intechstudio/grid-hardware/Electrical/Design/PCBA-ZONA-TOUCH/PCBA-ZONA-TOUCH.kicad_pcb

## KiCad design Electrical/Design/PCBA-ZONA-TOUCH/PCBA-ZONA-TOUCH.kicad_pcb (2026-10-08)

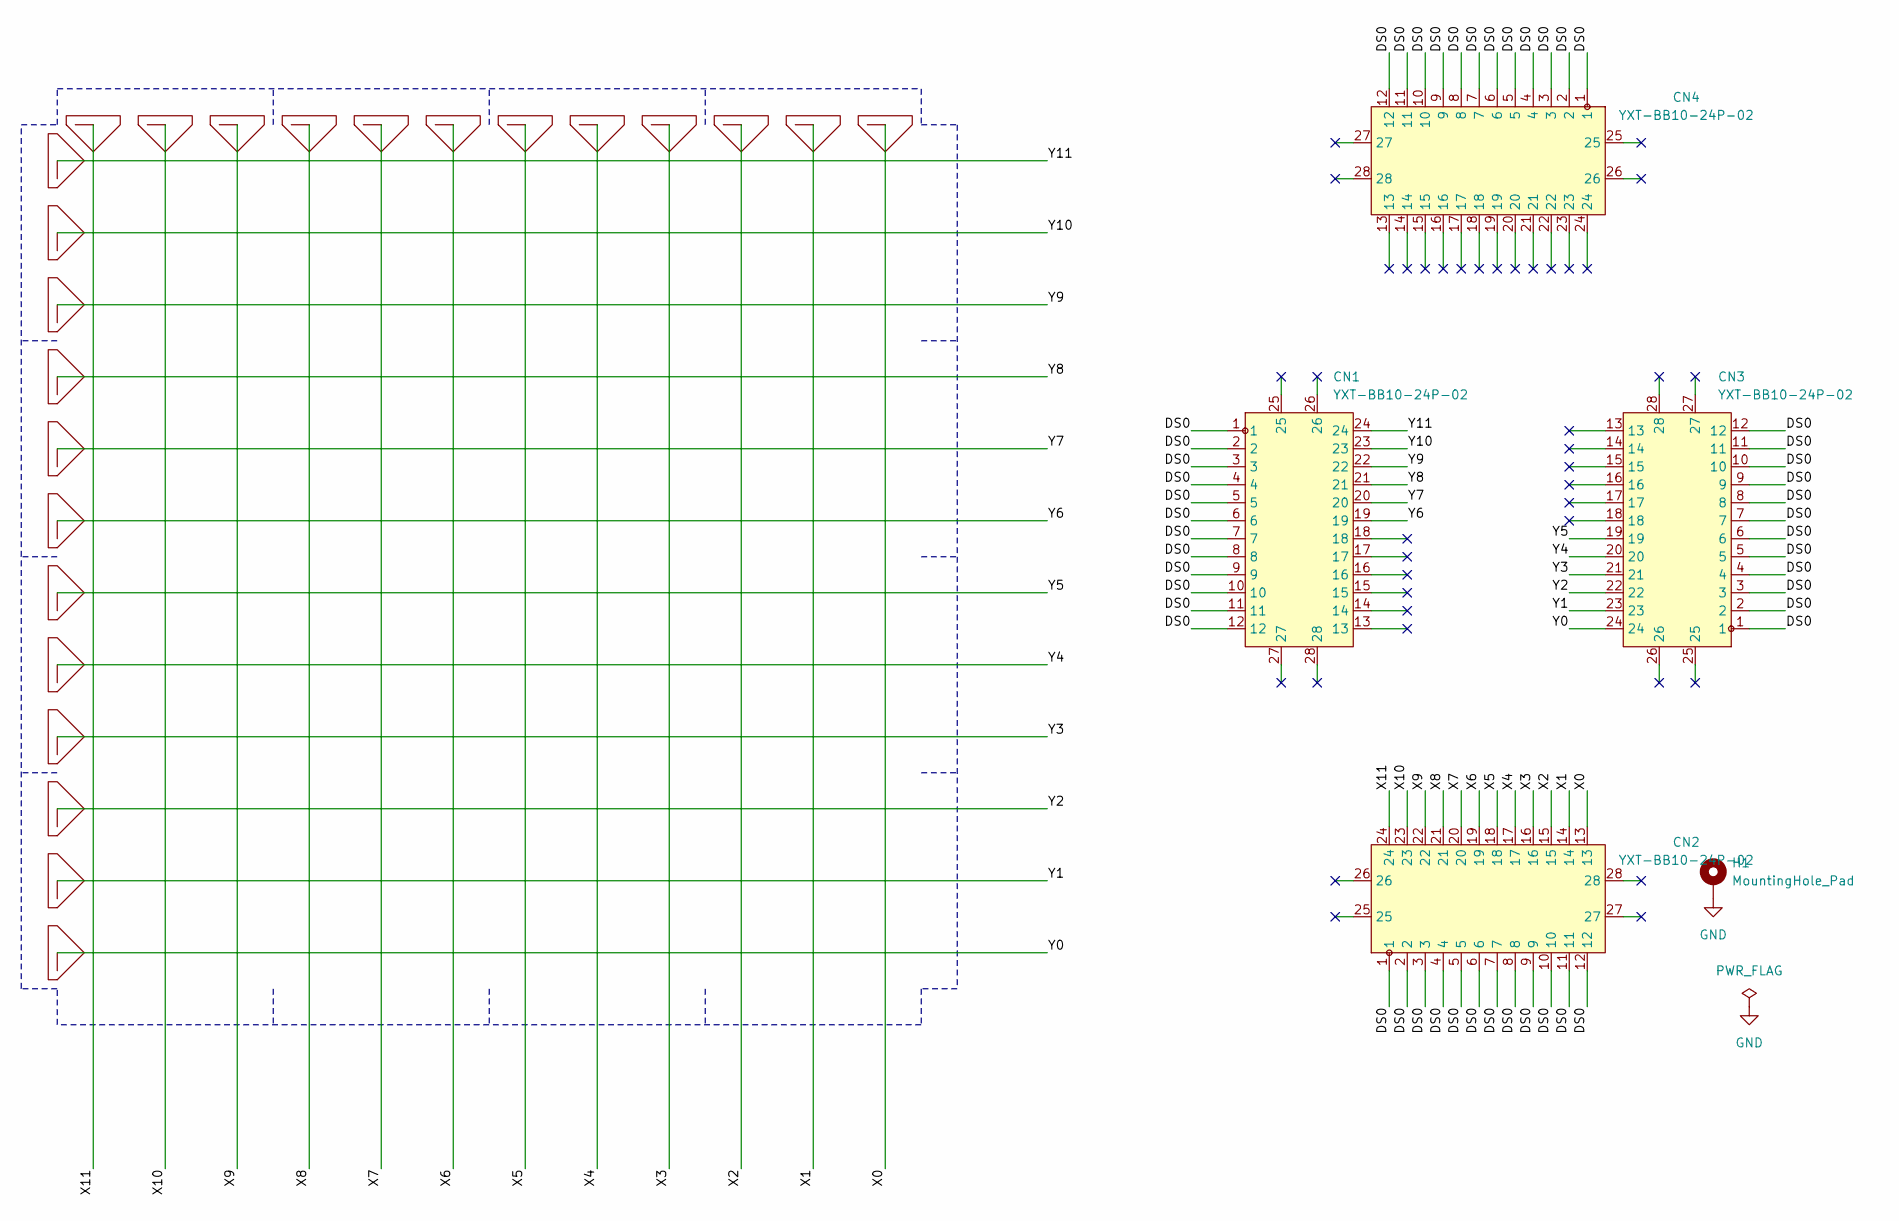
[picture p1: schematic PCBA-ZONA-TOUCH.kicad_sch]

Parts:
CN1, CN2, CN3, CN4: YXT-BB10-24P-02; CONN-SMD_24P-P0.4-YXT-BB10-24P-02; MPN YXT-BB10-24P-02; LCSC Part C2763973
CS1, CS2, CS3, CS4, CS5, CS6, CS7, CS8, CS9, CS10, CS11, CS12, CS13, CS38, CS63, CS88, CS113, CS138, CS163, CS188, CS213, CS238, CS263, CS288: capsense_diamond_edge; capsense_column
H1: MountingHole_Pad; zona-edgeplate-via

Connections:
/DS0: CN1.1, CN1.2, CN1.3, CN1.4, CN1.5, CN1.6, CN1.7, CN1.8, CN1.9, CN1.10, CN1.11, CN1.12, CN2.1, CN2.2, CN2.3, CN2.4, CN2.5, CN2.6, CN2.7, CN2.8, CN2.9, CN2.10, CN2.11, CN2.12, CN3.1, CN3.2, CN3.3, CN3.4, CN3.5, CN3.6, CN3.7, CN3.8, CN3.9, CN3.10, CN3.11, CN3.12, CN4.1, CN4.2, CN4.3, CN4.4, CN4.5, CN4.6, CN4.7, CN4.8, CN4.9, CN4.10, CN4.11, CN4.12
/X0: CN2.13, CS288.1 (1_1)
/X1: CN2.14, CS263.1 (1_1)
/X2: CN2.15, CS238.1 (1_1)
/X3: CN2.16, CS213.1 (1_1)
/X4: CN2.17, CS188.1 (1_1)
/X5: CN2.18, CS163.1 (1_1)
/X6: CN2.19, CS138.1 (1_1)
/X7: CN2.20, CS113.1 (1_1)
/X8: CN2.21, CS88.1 (1_1)
/X9: CN2.22, CS63.1 (1_1)
/X10: CN2.23, CS38.1 (1_1)
/X11: CN2.24, CS13.1 (1_1)
/Y0: CN3.24, CS12.1 (1_1)
/Y1: CN3.23, CS11.1 (1_1)
/Y2: CN3.22, CS10.1 (1_1)
/Y3: CN3.21, CS9.1 (1_1)
/Y4: CN3.20, CS8.1 (1_1)
/Y5: CN3.19, CS7.1 (1_1)
/Y6: CN1.19, CS6.1 (1_1)
/Y7: CN1.20, CS5.1 (1_1)
/Y8: CN1.21, CS4.1 (1_1)
/Y9: CN1.22, CS3.1 (1_1)
/Y10: CN1.23, CS2.1 (1_1)
/Y11: CN1.24, CS1.1 (1_1)
GND: H1.1 (1_1)

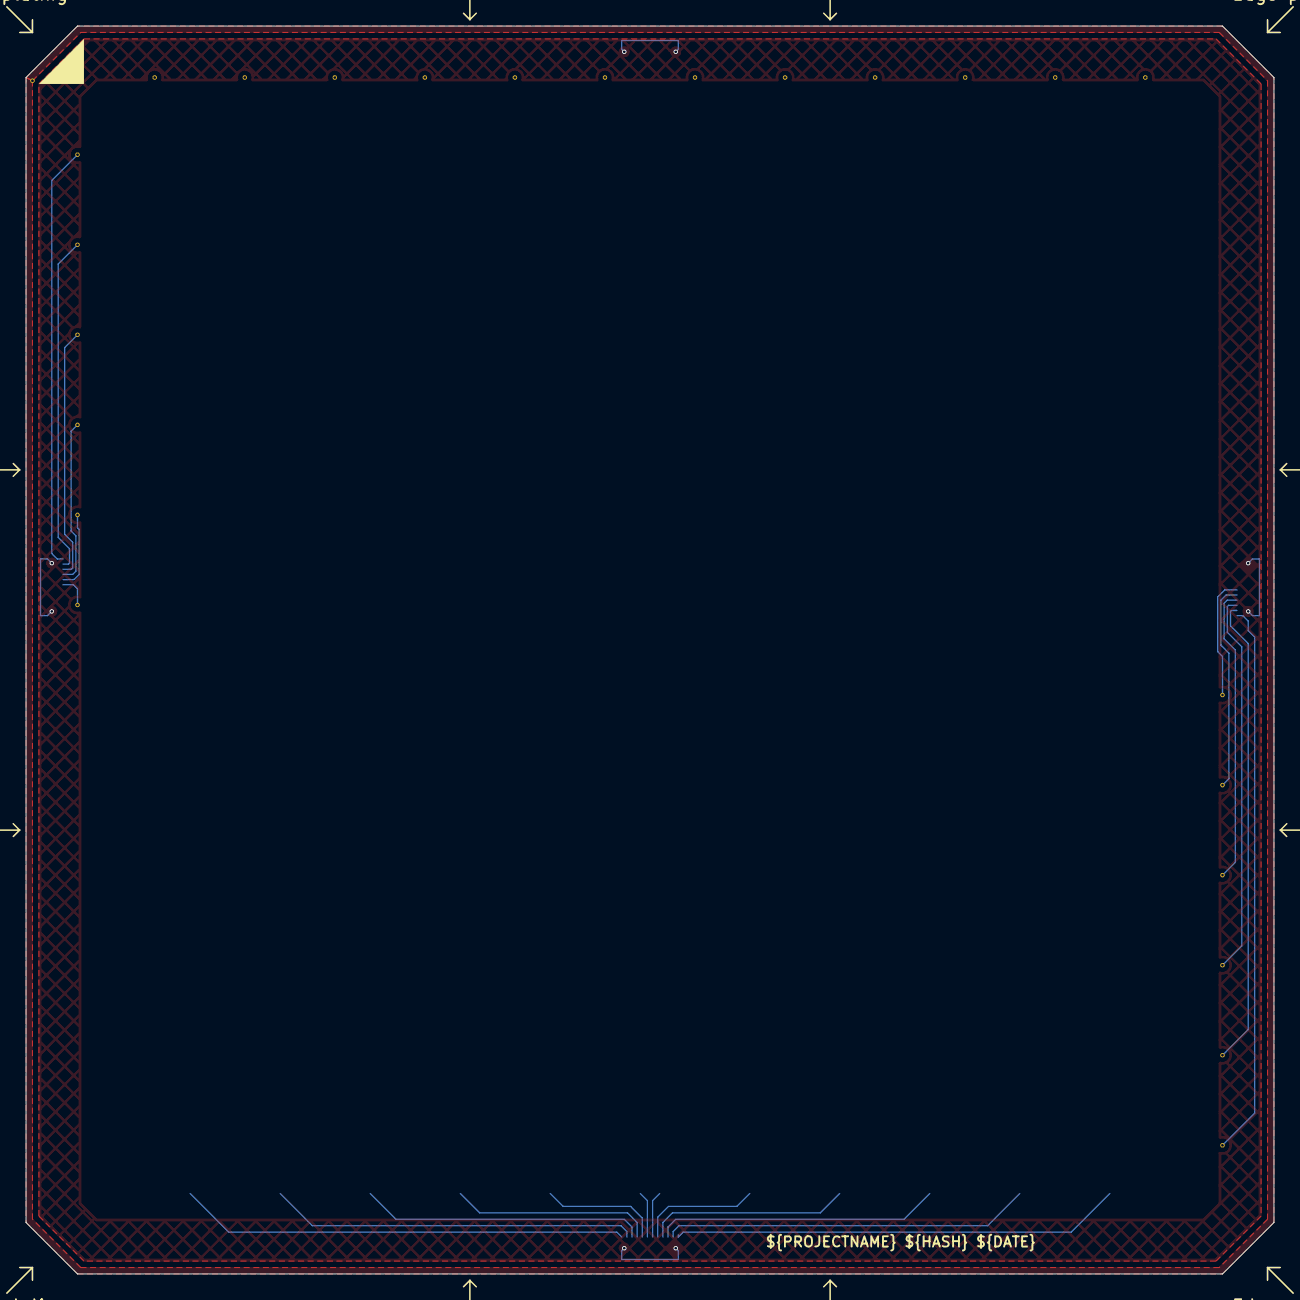
[picture p2: board PCBA-ZONA-TOUCH.kicad_pcb from above]

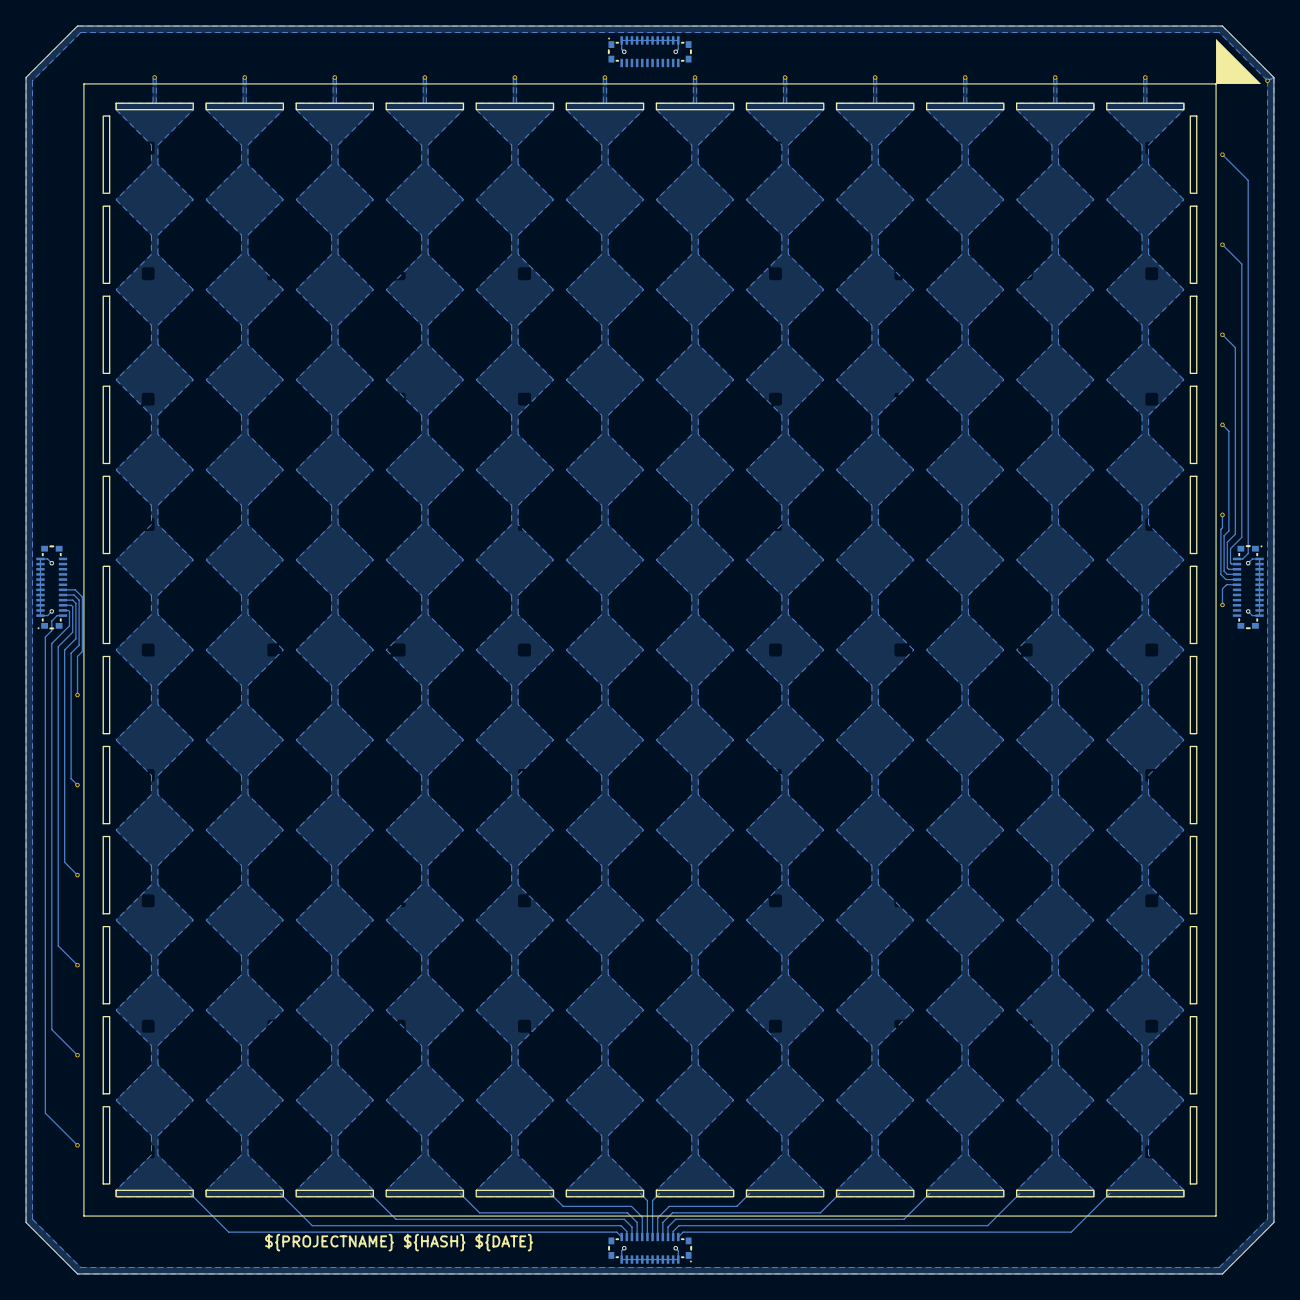
[picture p3: board PCBA-ZONA-TOUCH.kicad_pcb from below]

Board: 4 copper layers, 97.0 x 97.0 mm, 29 parts (4 on the bottom side), 25 nets.
