intechstudio/grid-hardware/Electrical/Design/PCBA-PO16/PCBA-PO16.kicad_pcb

## KiCad design Electrical/Design/PCBA-PO16/PCBA-PO16.kicad_pcb (2026-09-08)

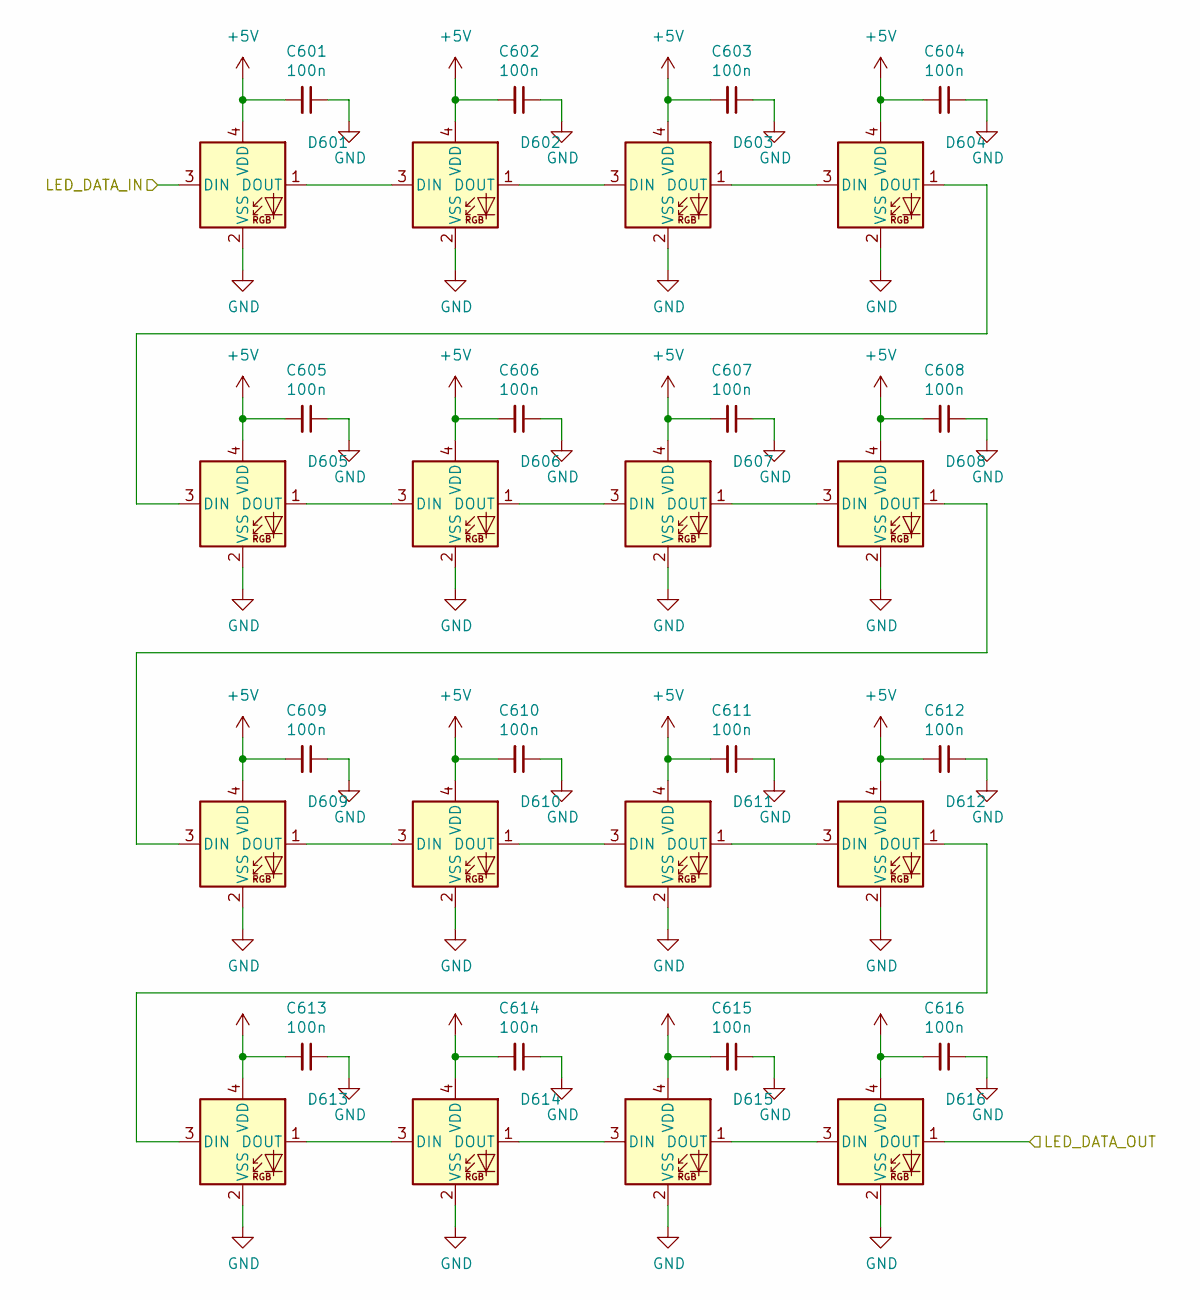
[picture p9: schematic UI_LED.kicad_sch]

Parts:
C601, C602, C603, C604, C605, C606, C607, C608, C609, C610, C611, C612, C613, C614, C615, C616: 100n; CAP_0402
D601, D602, D603, D604, D605, D606, D607, D608, D609, D610, D611, D612, D613, D614, D615, D616: XL-0807RGBC-2812B-S; UI_XL-0807RGBC-2812B-S

Connections:
+5V: C601.2, C602.2, C603.2, C604.2, C605.2, C606.2, C607.2, C608.2, C609.2, C610.2, C611.2, C612.2, C613.2, C614.2, C615.2, C616.2, D601.4 (VDD), D602.4 (VDD), D603.4 (VDD), D604.4 (VDD), D605.4 (VDD), D606.4 (VDD), D607.4 (VDD), D608.4 (VDD), D609.4 (VDD), D610.4 (VDD), D611.4 (VDD), D612.4 (VDD), D613.4 (VDD), D614.4 (VDD), D615.4 (VDD), D616.4 (VDD); also elsewhere on the board
/MCU/LED_DATA_OUT: D601.3 (DIN); also elsewhere on the board
/UI_LED/LED_DATA_OUT: D616.1 (DOUT)
GND: C601.1, C602.1, C603.1, C604.1, C605.1, C606.1, C607.1, C608.1, C609.1, C610.1, C611.1, C612.1, C613.1, C614.1, C615.1, C616.1, D601.2 (VSS), D602.2 (VSS), D603.2 (VSS), D604.2 (VSS), D605.2 (VSS), D606.2 (VSS), D607.2 (VSS), D608.2 (VSS), D609.2 (VSS), D610.2 (VSS), D611.2 (VSS), D612.2 (VSS), D613.2 (VSS), D614.2 (VSS), D615.2 (VSS), D616.2 (VSS); also elsewhere on the board
unnamed: D601.1 (DOUT), D602.3 (DIN)
unnamed: D602.1 (DOUT), D603.3 (DIN)
unnamed: D603.1 (DOUT), D604.3 (DIN)
unnamed: D604.1 (DOUT), D605.3 (DIN)
unnamed: D605.1 (DOUT), D606.3 (DIN)
unnamed: D606.1 (DOUT), D607.3 (DIN)
unnamed: D607.1 (DOUT), D608.3 (DIN)
unnamed: D608.1 (DOUT), D609.3 (DIN)
unnamed: D609.1 (DOUT), D610.3 (DIN)
unnamed: D610.1 (DOUT), D611.3 (DIN)
unnamed: D611.1 (DOUT), D612.3 (DIN)
unnamed: D612.1 (DOUT), D613.3 (DIN)
unnamed: D613.1 (DOUT), D614.3 (DIN)
unnamed: D614.1 (DOUT), D615.3 (DIN)
unnamed: D615.1 (DOUT), D616.3 (DIN)

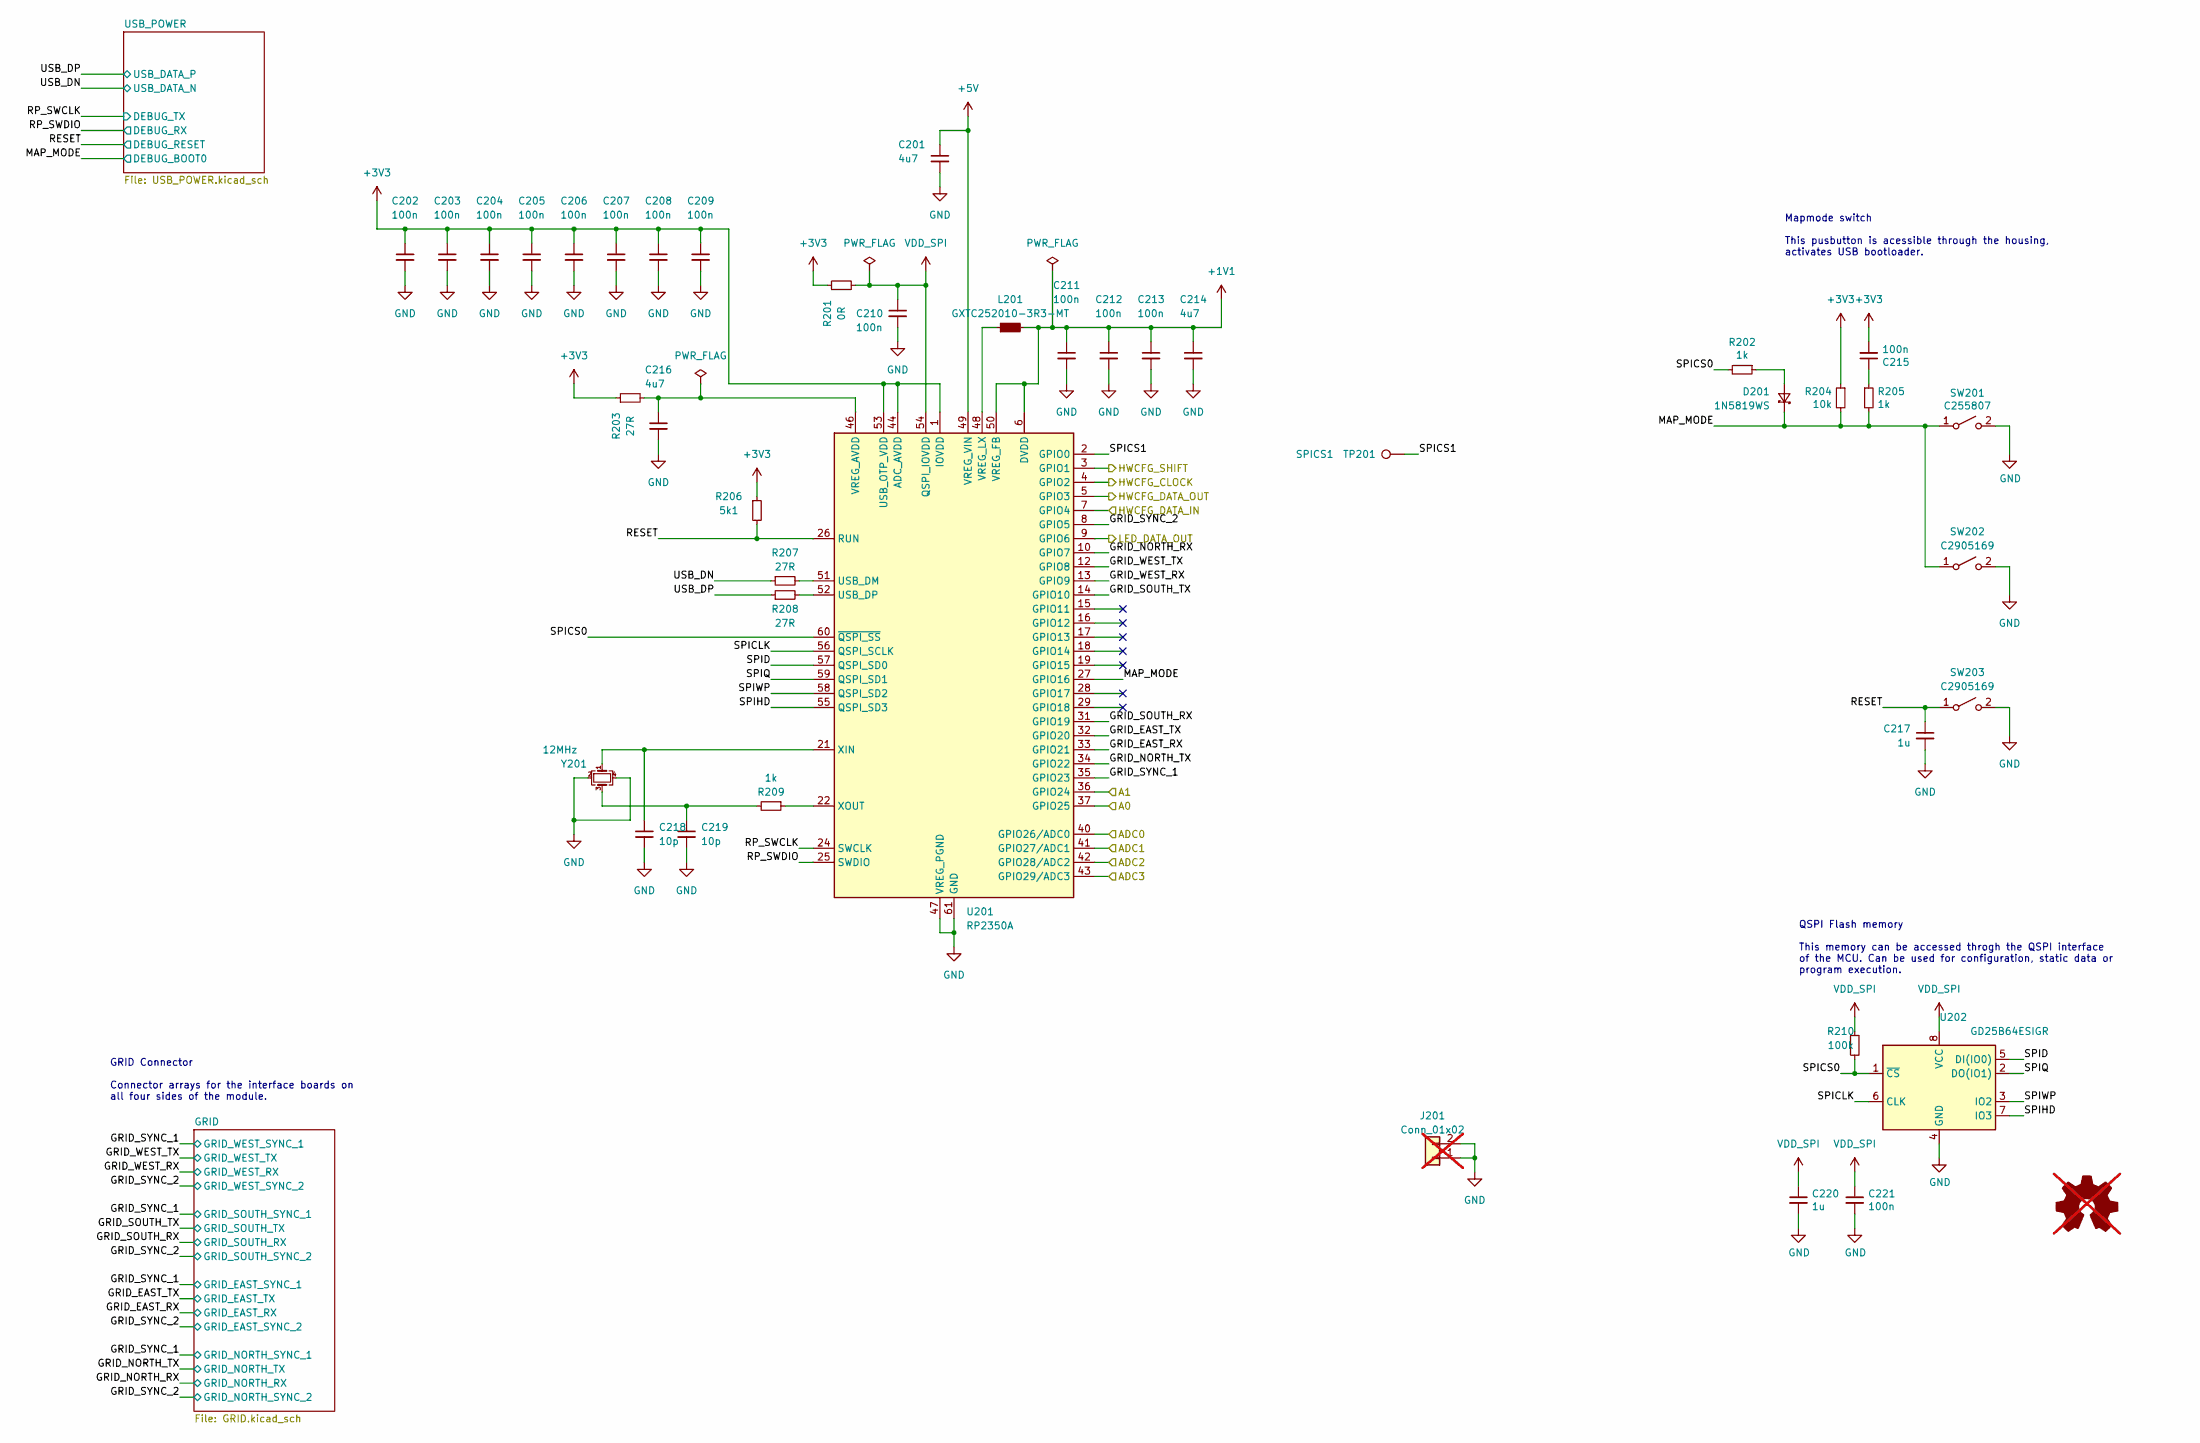
[picture p10: schematic MCU.kicad_sch]

Parts:
C201, C214, C216: 4u7; CAP_0402
C202, C203, C204, C205, C206, C207, C208, C209, C210, C211, C212, C213, C215, C221: 100n; CAP_0402
C217, C220: 1u; CAP_0402
C218, C219: 10p; CAP_0402
D201: 1N5819WS; D_SOD-323
J201: Conn_01x02; OscilloscopeGround; not fitted
L201: GXTC252010-3R3-MT; L_1008_2520Metric
LOGO201: OSHWA; not fitted
R201: 0R; RES_0402
R202, R205, R209: 1k; RES_0402
R203, R207, R208: 27R; RES_0402
R204: 10k; RES_0402
R206: 5k1; RES_0402
R210: 100k; RES_0402
SW201: C255807; SW_HYP_MAPMODE
SW202, SW203: C2905169; SW_SPST_CK_RS282G05A3
TP201: SPICS1; TestPoint_Pad_D1.0mm
U201: RP2350A; QFN-60-1EP_7x7mm_P0.4mm_EP3.4x3.4mm
U202: GD25B64ESIGR; SOIC-8W_FLASH
Y201: 12MHz; Crystal_SMD_Abracon_ABM8G-4Pin_3.2x2.5mm

Connections:
+1V1: C211.1, C212.1, C213.1, C214.1, L201.2, U201.6 (DVDD), U201.23 (DVDD), U201.39 (DVDD), U201.50 (VREG_FB)
+3V3: C202.1, C203.1, C204.1, C205.1, C206.1, C207.1, C208.1, C209.1, C215.2, R201.1, R203.1, R204.1, R206.1, U201.1 (IOVDD), U201.11 (IOVDD), U201.20 (IOVDD), U201.30 (IOVDD), U201.38 (IOVDD), U201.44 (ADC_AVDD), U201.45 (IOVDD), U201.53 (USB_OTP_VDD); also elsewhere on the board
+5V: C201.1, U201.49 (VREG_VIN); also elsewhere on the board
/HWCFG/HWCFG_CLOCK: U201.4 (GPIO2); also elsewhere on the board
/HWCFG/HWCFG_DATA_IN: U201.7 (GPIO4); also elsewhere on the board
/HWCFG/HWCFG_SHIFT: U201.3 (GPIO1); also elsewhere on the board
/MCU/A0: U201.37 (GPIO25); also elsewhere on the board
/MCU/A1: U201.36 (GPIO24); also elsewhere on the board
/MCU/ADC0: U201.40 (GPIO26/ADC0); also elsewhere on the board
/MCU/ADC1: U201.41 (GPIO27/ADC1); also elsewhere on the board
/MCU/ADC2: U201.42 (GPIO28/ADC2); also elsewhere on the board
/MCU/ADC3: U201.43 (GPIO29/ADC3); also elsewhere on the board
/MCU/GPIO17: U201.28 (GPIO17)
/MCU/GPIO18: U201.29 (GPIO18)
/MCU/GRID_EAST_RX: U201.33 (GPIO21); also elsewhere on the board
/MCU/GRID_EAST_TX: U201.32 (GPIO20); also elsewhere on the board
/MCU/GRID_NORTH_RX: U201.10 (GPIO7); also elsewhere on the board
/MCU/GRID_NORTH_TX: U201.34 (GPIO22); also elsewhere on the board
/MCU/GRID_SOUTH_RX: U201.31 (GPIO19); also elsewhere on the board
/MCU/GRID_SOUTH_TX: U201.14 (GPIO10); also elsewhere on the board
/MCU/GRID_SYNC_1: U201.35 (GPIO23); also elsewhere on the board
/MCU/GRID_SYNC_2: U201.8 (GPIO5); also elsewhere on the board
/MCU/GRID_WEST_RX: U201.13 (GPIO9); also elsewhere on the board
/MCU/GRID_WEST_TX: U201.12 (GPIO8); also elsewhere on the board
/MCU/HWCFG_DATA_OUT: U201.5 (GPIO3)
/MCU/LED_DATA_OUT: U201.9 (GPIO6); also elsewhere on the board
/MCU/MAP_MODE: D201.1 (K), R204.2, R205.2, SW201.1 (A), SW202.1 (A), U201.27 (GPIO16); also elsewhere on the board
/MCU/RESET: C217.1, R206.2, SW203.1 (A), U201.26 (RUN); also elsewhere on the board
/MCU/RP_SWCLK: U201.24 (SWCLK); also elsewhere on the board
/MCU/RP_SWDIO: U201.25 (SWDIO); also elsewhere on the board
/MCU/SCL: U201.19 (GPIO15)
/MCU/SDA: U201.18 (GPIO14)
/MCU/SPICLK: U201.56 (QSPI_SCLK), U202.6 (CLK)
/MCU/SPICS0: R202.2, R210.2, U201.60 (~QSPI_SS), U202.1 (~CS)
/MCU/SPICS1: TP201.1 (1_1), U201.2 (GPIO0)
/MCU/SPID: U201.57 (QSPI_SD0), U202.5 (DI(IO0))
/MCU/SPIHD: U201.55 (QSPI_SD3), U202.7 (IO3)
/MCU/SPIQ: U201.59 (QSPI_SD1), U202.2 (DO(IO1))
/MCU/SPIWP: U201.58 (QSPI_SD2), U202.3 (IO2)
/MCU/USB_DN: R207.1; also elsewhere on the board
/MCU/USB_DP: R208.1; also elsewhere on the board
GND: C201.2, C202.2, C203.2, C204.2, C205.2, C206.2, C207.2, C208.2, C209.2, C210.2, C211.2, C212.2, C213.2, C214.2, C216.2, C217.2, C218.2, C219.2, C220.2, C221.2, J201.1, J201.2, SW201.2 (B), SW202.2 (B), SW203.2 (B), U201.47 (VREG_PGND), U201.61 (GND), U202.4 (GND), Y201.2, Y201.4; also elsewhere on the board
unnamed: C215.1, R205.1
unnamed: C219.1, R209.2, Y201.3
unnamed: D201.2 (A), R202.1
unnamed: R207.2, U201.51 (USB_DM)
unnamed: R208.2, U201.52 (USB_DP)
unnamed: C216.1, R203.2, U201.46 (VREG_AVDD)
unnamed: L201.1, U201.48 (VREG_LX)
unnamed: C218.1, U201.21 (XIN), Y201.1
unnamed: R209.1, U201.22 (XOUT)
VDD_SPI: C210.1, C220.1, C221.1, R201.2, R210.1, U201.54 (QSPI_IOVDD), U202.8 (VCC)

Notes on the sheet:
Mapmode switch This pusbutton is acessible through the housing, activates USB bootloader.
QSPI Flash memory This memory can be accessed throgh the QSPI interface of the MCU. Can be used for configuration, static data or program execution.
GRID Connector Connector arrays for the interface boards on all four sides of the module.

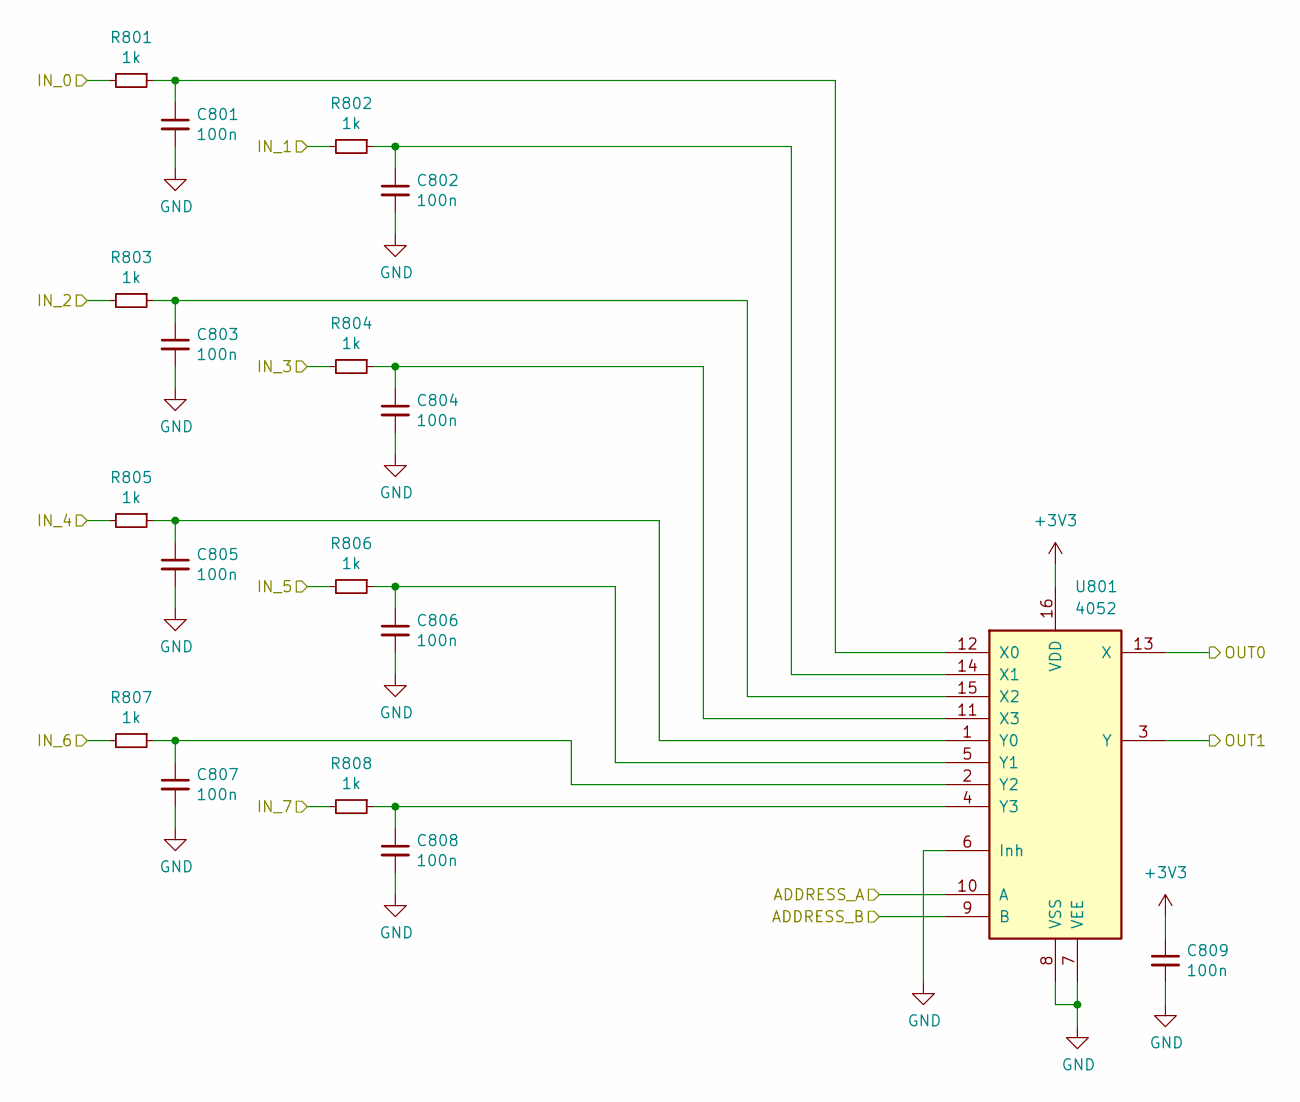
[picture p11: schematic UI_MUX.kicad_sch]

Parts:
C801, C802, C803, C804, C805, C806, C807, C808, C809: 100n; CAP_0402
R801, R802, R803, R804, R805, R806, R807, R808: 1k; RES_0402
U801: 4052; SOIC-16_74HC4051

Connections:
+3V3: C809.1, U801.16 (VDD); also elsewhere on the board
/ANA_0: R801.2; also elsewhere on the board
/ANA_1: R802.2; also elsewhere on the board
/ANA_4: R803.2; also elsewhere on the board
/ANA_5: R804.2; also elsewhere on the board
/ANA_8: R805.2; also elsewhere on the board
/ANA_9: R806.2; also elsewhere on the board
/ANA_12: R807.2; also elsewhere on the board
/ANA_13: R808.2; also elsewhere on the board
/MCU/A0: U801.10 (A); also elsewhere on the board
/MCU/A1: U801.9 (B); also elsewhere on the board
/MCU/ADC0: U801.13 (X); also elsewhere on the board
/MCU/ADC1: U801.3 (Y); also elsewhere on the board
GND: C801.2, C802.2, C803.2, C804.2, C805.2, C806.2, C807.2, C808.2, C809.2, U801.6 (Inh), U801.7 (VEE), U801.8 (VSS); also elsewhere on the board
unnamed: C801.1, R801.1, U801.12 (X0)
unnamed: C802.1, R802.1, U801.14 (X1)
unnamed: C803.1, R803.1, U801.15 (X2)
unnamed: C804.1, R804.1, U801.11 (X3)
unnamed: C805.1, R805.1, U801.1 (Y0)
unnamed: C806.1, R806.1, U801.5 (Y1)
unnamed: C807.1, R807.1, U801.2 (Y2)
unnamed: C808.1, R808.1, U801.4 (Y3)

Parts of its further copies:
C901, C902, C903, C904, C905, C906, C907, C908, C909: 100n; CAP_0402
R901, R902, R903, R904, R905, R906, R907, R908: 1k; RES_0402
U901: 4052; SOIC-16_74HC4051

Connections of its further copies:
+3V3: C909.1, U901.16 (VDD); also elsewhere on the board
/ANA_2: R901.2; also elsewhere on the board
/ANA_3: R902.2; also elsewhere on the board
/ANA_6: R903.2; also elsewhere on the board
/ANA_7: R904.2; also elsewhere on the board
/ANA_10: R905.2; also elsewhere on the board
/ANA_11: R906.2; also elsewhere on the board
/ANA_14: R907.2; also elsewhere on the board
/ANA_15: R908.2; also elsewhere on the board
/MCU/A0: U901.10 (A); also elsewhere on the board
/MCU/A1: U901.9 (B); also elsewhere on the board
/MCU/ADC2: U901.13 (X); also elsewhere on the board
/MCU/ADC3: U901.3 (Y); also elsewhere on the board
GND: C901.2, C902.2, C903.2, C904.2, C905.2, C906.2, C907.2, C908.2, C909.2, U901.6 (Inh), U901.7 (VEE), U901.8 (VSS); also elsewhere on the board
unnamed: C901.1, R901.1, U901.12 (X0)
unnamed: C902.1, R902.1, U901.14 (X1)
unnamed: C903.1, R903.1, U901.15 (X2)
unnamed: C904.1, R904.1, U901.11 (X3)
unnamed: C905.1, R905.1, U901.1 (Y0)
unnamed: C906.1, R906.1, U901.5 (Y1)
unnamed: C907.1, R907.1, U901.2 (Y2)
unnamed: C908.1, R908.1, U901.4 (Y3)

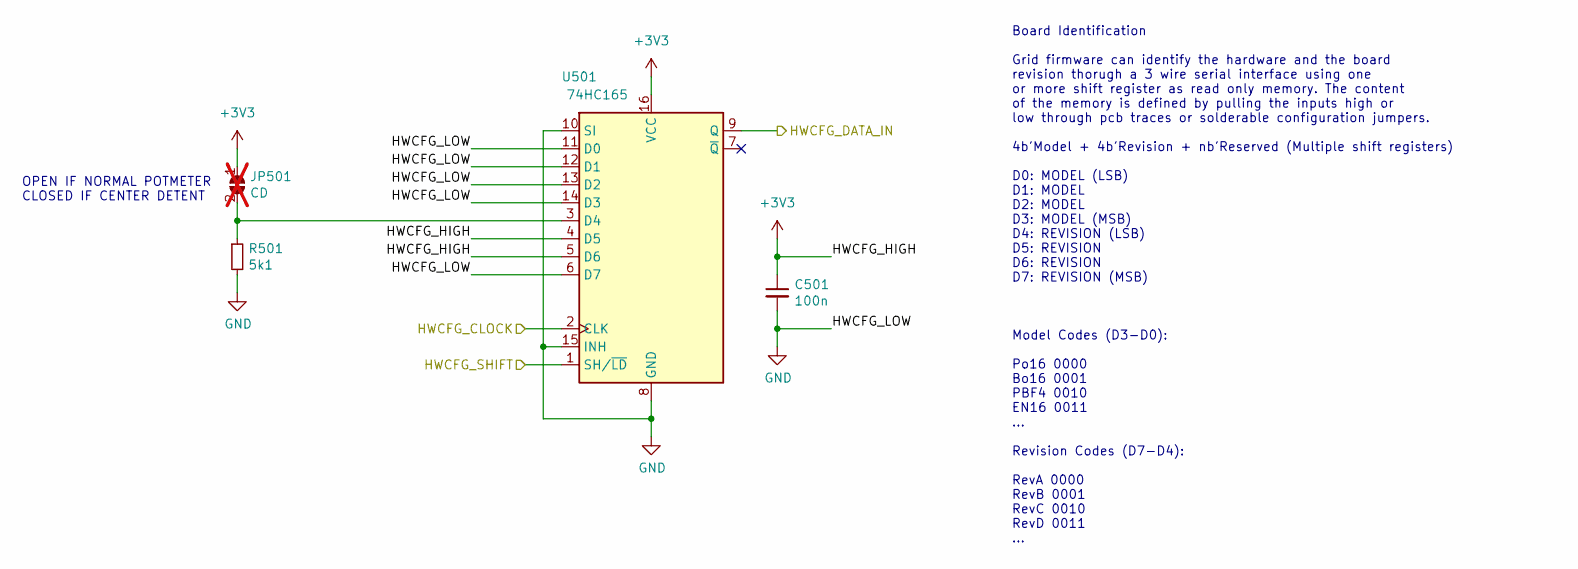
[picture p12: schematic HWCFG.kicad_sch]

Parts:
C501: 100n; CAP_0402
JP501: CD; SolderJumper-2_P1.3mm_Open_TrianglePad1.0x1.5mm; not fitted
R501: 5k1; RES_0402
U501: 74HC165; SOIC-16_74HC165

Connections:
+3V3: C501.1, JP501.1 (A), U501.4 (D5), U501.5 (D6), U501.16 (VCC); also elsewhere on the board
/HWCFG/HWCFG_CLOCK: U501.2 (CLK); also elsewhere on the board
/HWCFG/HWCFG_DATA_IN: U501.9 (Q); also elsewhere on the board
/HWCFG/HWCFG_SHIFT: U501.1 (SH/~LD); also elsewhere on the board
GND: C501.2, R501.2, U501.6 (D7), U501.8 (GND), U501.10 (SI), U501.11 (D0), U501.12 (D1), U501.13 (D2), U501.14 (D3), U501.15 (INH); also elsewhere on the board
unnamed: JP501.2 (B), R501.1, U501.3 (D4)

Notes on the sheet:
Board Identification Grid firmware can identify the hardware and the board revision thorugh a 3 wire serial interface using one or more shift register as read only memory. The content of the memory is defined by pulling the inputs high or low through pcb traces or solderable configuration jumpers. 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
OPEN IF NORMAL POTMETER CLOSED IF CENTER DETENT

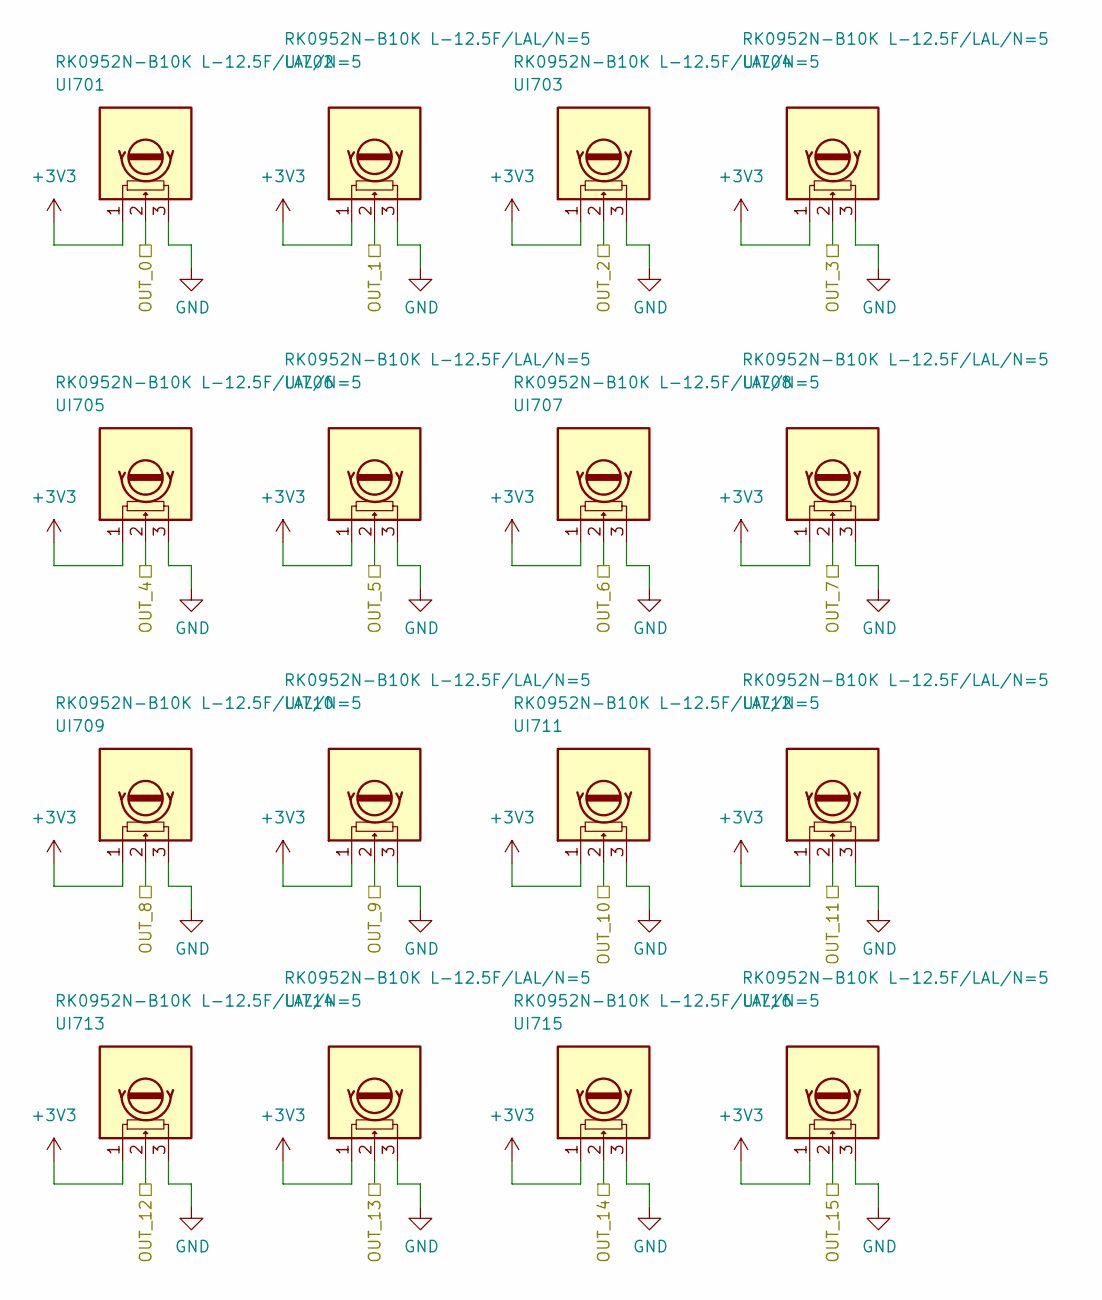
[picture p13: schematic UI_POT.kicad_sch]

Parts:
UI701, UI702, UI703, UI704, UI705, UI706, UI707, UI708, UI709, UI710, UI711, UI712, UI713, UI714, UI715, UI716: RK0952N-B10K L-12.5F/LAL/N=5; UI_POT_SONGHUEI

Connections:
+3V3: UI701.1, UI702.1, UI703.1, UI704.1, UI705.1, UI706.1, UI707.1, UI708.1, UI709.1, UI710.1, UI711.1, UI712.1, UI713.1, UI714.1, UI715.1, UI716.1; also elsewhere on the board
/ANA_0: UI701.2; also elsewhere on the board
/ANA_1: UI702.2; also elsewhere on the board
/ANA_2: UI703.2; also elsewhere on the board
/ANA_3: UI704.2; also elsewhere on the board
/ANA_4: UI705.2; also elsewhere on the board
/ANA_5: UI706.2; also elsewhere on the board
/ANA_6: UI707.2; also elsewhere on the board
/ANA_7: UI708.2; also elsewhere on the board
/ANA_8: UI709.2; also elsewhere on the board
/ANA_9: UI710.2; also elsewhere on the board
/ANA_10: UI711.2; also elsewhere on the board
/ANA_11: UI712.2; also elsewhere on the board
/ANA_12: UI713.2; also elsewhere on the board
/ANA_13: UI714.2; also elsewhere on the board
/ANA_14: UI715.2; also elsewhere on the board
/ANA_15: UI716.2; also elsewhere on the board
GND: UI701.3, UI702.3, UI703.3, UI704.3, UI705.3, UI706.3, UI707.3, UI708.3, UI709.3, UI710.3, UI711.3, UI712.3, UI713.3, UI714.3, UI715.3, UI716.3; also elsewhere on the board

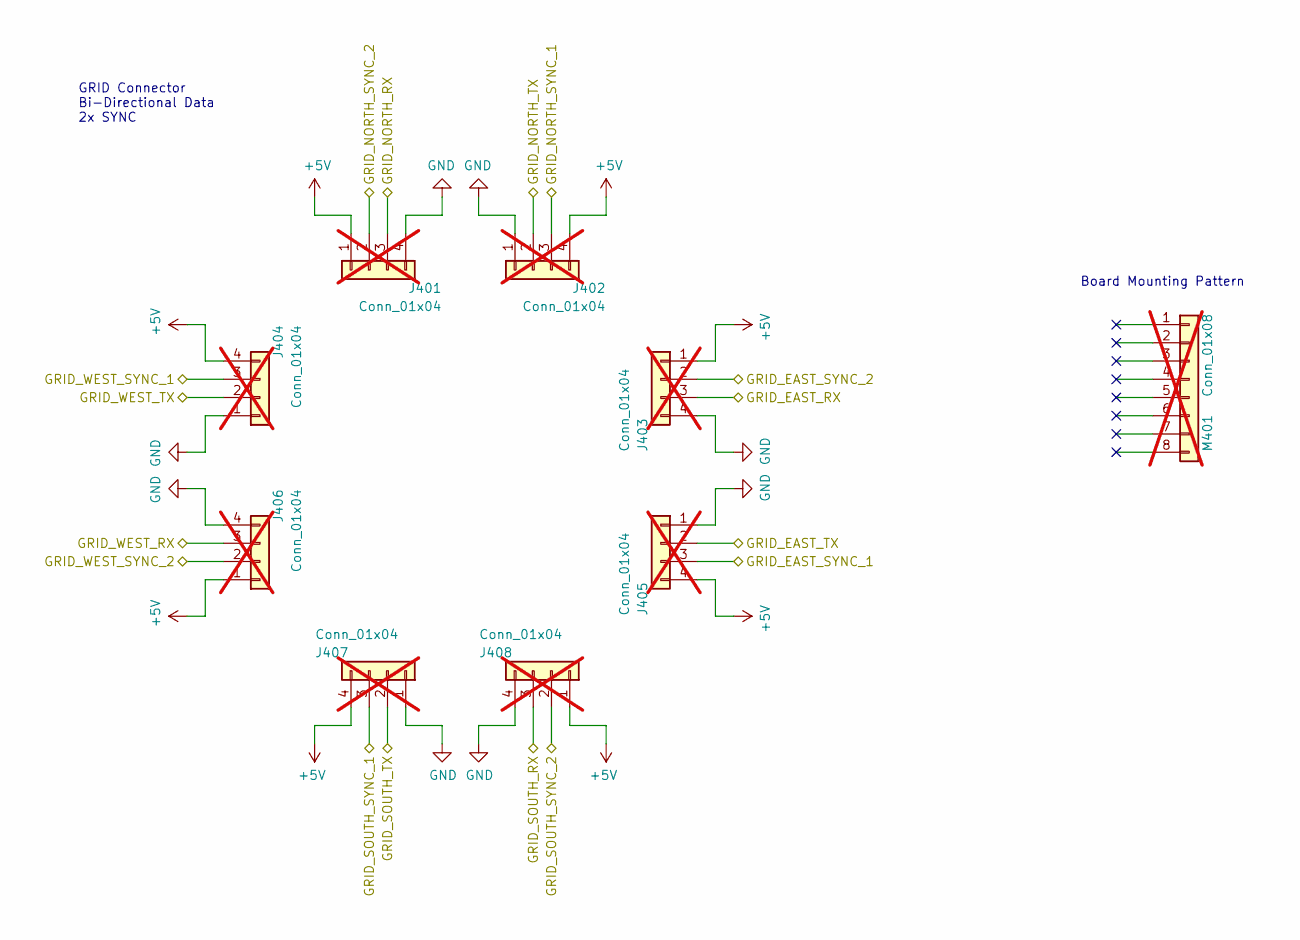
[picture p14: schematic GRID.kicad_sch]

Parts:
J401, J402, J403, J404, J405, J406, J407, J408: Conn_01x04; J_INTERFACE_SPRINGPATTERN; not fitted
M401: Conn_01x08; grid_outline; not fitted

Connections:
+5V: J401.1, J402.4, J403.1, J404.4, J405.4, J406.1, J407.4, J408.1; also elsewhere on the board
/MCU/GRID_EAST_RX: J403.3; also elsewhere on the board
/MCU/GRID_EAST_TX: J405.2; also elsewhere on the board
/MCU/GRID_NORTH_RX: J401.3; also elsewhere on the board
/MCU/GRID_NORTH_TX: J402.2; also elsewhere on the board
/MCU/GRID_SOUTH_RX: J408.3; also elsewhere on the board
/MCU/GRID_SOUTH_TX: J407.2; also elsewhere on the board
/MCU/GRID_SYNC_1: J402.3, J404.3, J405.3, J407.3; also elsewhere on the board
/MCU/GRID_SYNC_2: J401.2, J403.2, J406.2, J408.2; also elsewhere on the board
/MCU/GRID_WEST_RX: J406.3; also elsewhere on the board
/MCU/GRID_WEST_TX: J404.2; also elsewhere on the board
GND: J401.4, J402.1, J403.4, J404.1, J405.1, J406.4, J407.1, J408.4; also elsewhere on the board

Notes on the sheet:
Board Mounting Pattern
GRID Connector Bi-Directional Data 2x SYNC

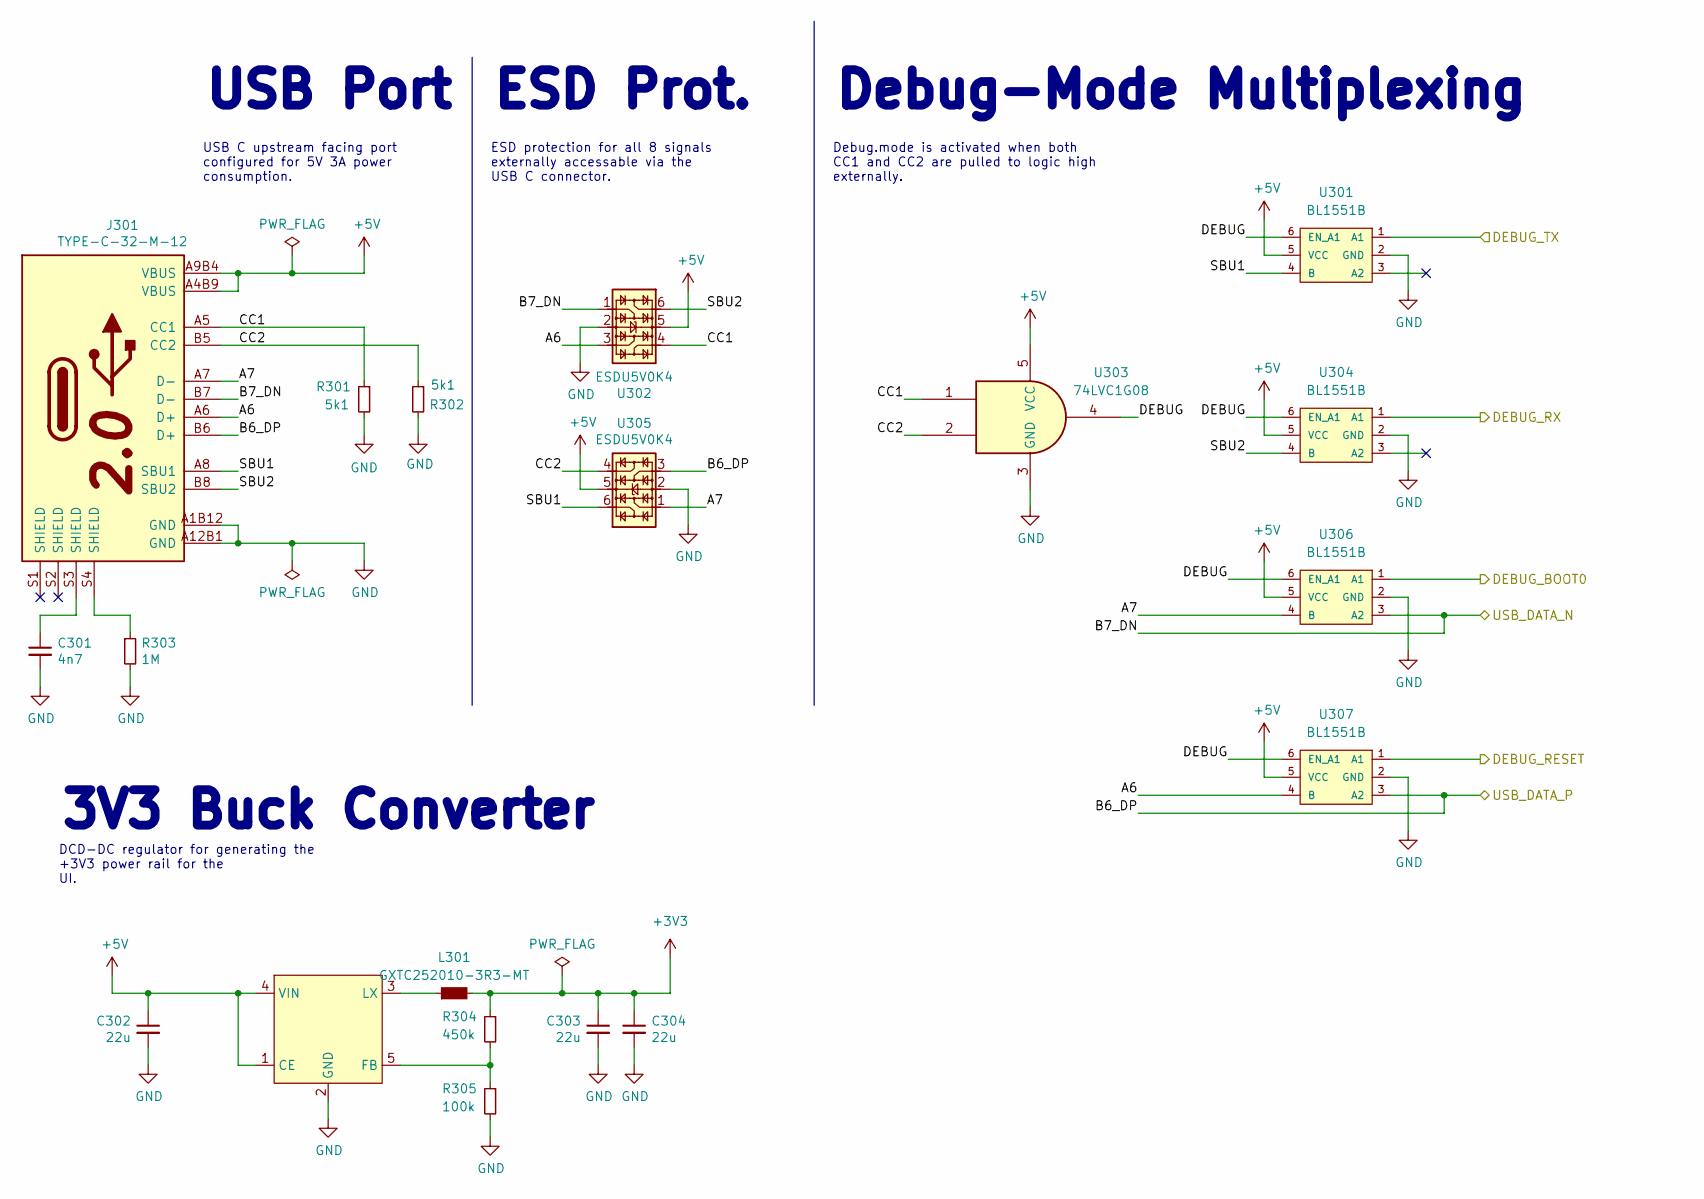
[picture p15: schematic USB_POWER.kicad_sch]

Parts:
C301: 4n7; CAP_0402
C302, C303, C304: 22u; CAP_0603
J301: TYPE-C-32-M-12; USB_C_Korean_Hroparts_TYPE-C-31-M-12
L301: GXTC252010-3R3-MT; L_1008_2520Metric
R301, R302: 5k1; RES_0402
R303: 1M; RES_0402
R304: 450k; RES_0402
R305: 100k; RES_0402
U301, U304, U306, U307: BL1551B; SOT-363_SC-70-6
U302, U305: ESDU5V0K4; SOT-363_SC-70-6
U303: 74LVC1G08; SOT-23-5-AND-TSSOP5
U308: RY3409; SOT-23-5; MPN HX3406; LCSC Part C296282

Connections:
+3V3: C303.1, C304.1, L301.2, R304.1; also elsewhere on the board
+5V: C302.1, J301.A4B9 (VBUS), J301.A9B4 (VBUS), U301.5 (VCC), U302.5, U303.5 (VCC), U304.5 (VCC), U305.5, U306.5 (VCC), U307.5 (VCC), U308.1 (CE), U308.4 (VIN); also elsewhere on the board
/MCU/MAP_MODE: U306.1 (A1); also elsewhere on the board
/MCU/RESET: U307.1 (A1); also elsewhere on the board
/MCU/RP_SWCLK: U301.1 (A1); also elsewhere on the board
/MCU/RP_SWDIO: U304.1 (A1); also elsewhere on the board
/MCU/USB_DN: J301.B7 (D-), U302.1, U306.3 (A2); also elsewhere on the board
/MCU/USB_DP: J301.B6 (D+), U305.3, U307.3 (A2); also elsewhere on the board
/MCU/USB_POWER/A6: J301.A6 (D+), U302.3, U307.4 (B)
/MCU/USB_POWER/A7: J301.A7 (D-), U305.1, U306.4 (B)
/MCU/USB_POWER/CC1: J301.A5 (CC1), R301.1, U302.4, U303.1
/MCU/USB_POWER/CC2: J301.B5 (CC2), R302.1, U303.2, U305.4
/MCU/USB_POWER/DEBUG: U301.6 (EN_A1), U303.4, U304.6 (EN_A1), U306.6 (EN_A1), U307.6 (EN_A1)
/MCU/USB_POWER/SBU1: J301.A8 (SBU1), U301.4 (B), U305.6
/MCU/USB_POWER/SBU2: J301.B8 (SBU2), U302.6, U304.4 (B)
GND: C301.2, C302.2, C303.2, C304.2, J301.A1B12 (GND), J301.A12B1 (GND), R301.2, R302.2, R303.2, R305.2, U301.2 (GND), U302.2, U303.3 (GND), U304.2 (GND), U305.2, U306.2 (GND), U307.2 (GND), U308.2 (GND); also elsewhere on the board
unnamed: C301.1, J301.S3 (SHIELD)
unnamed: J301.S4 (SHIELD), R303.1
unnamed: R304.2, R305.1, U308.5 (FB)
unnamed: L301.1, U308.3 (LX)

Notes on the sheet:
Debug.mode is activated when both CC1 and CC2 are pulled to logic high externally.
ESD protection for all 8 signals externally accessable via the USB C connector.
ESD Prot.
DCD-DC regulator for generating the +3V3 power rail for the UI.
USB Port
3V3 Buck Converter
USB C upstream facing port configured for 5V 3A power consumption.
Debug-Mode Multiplexing

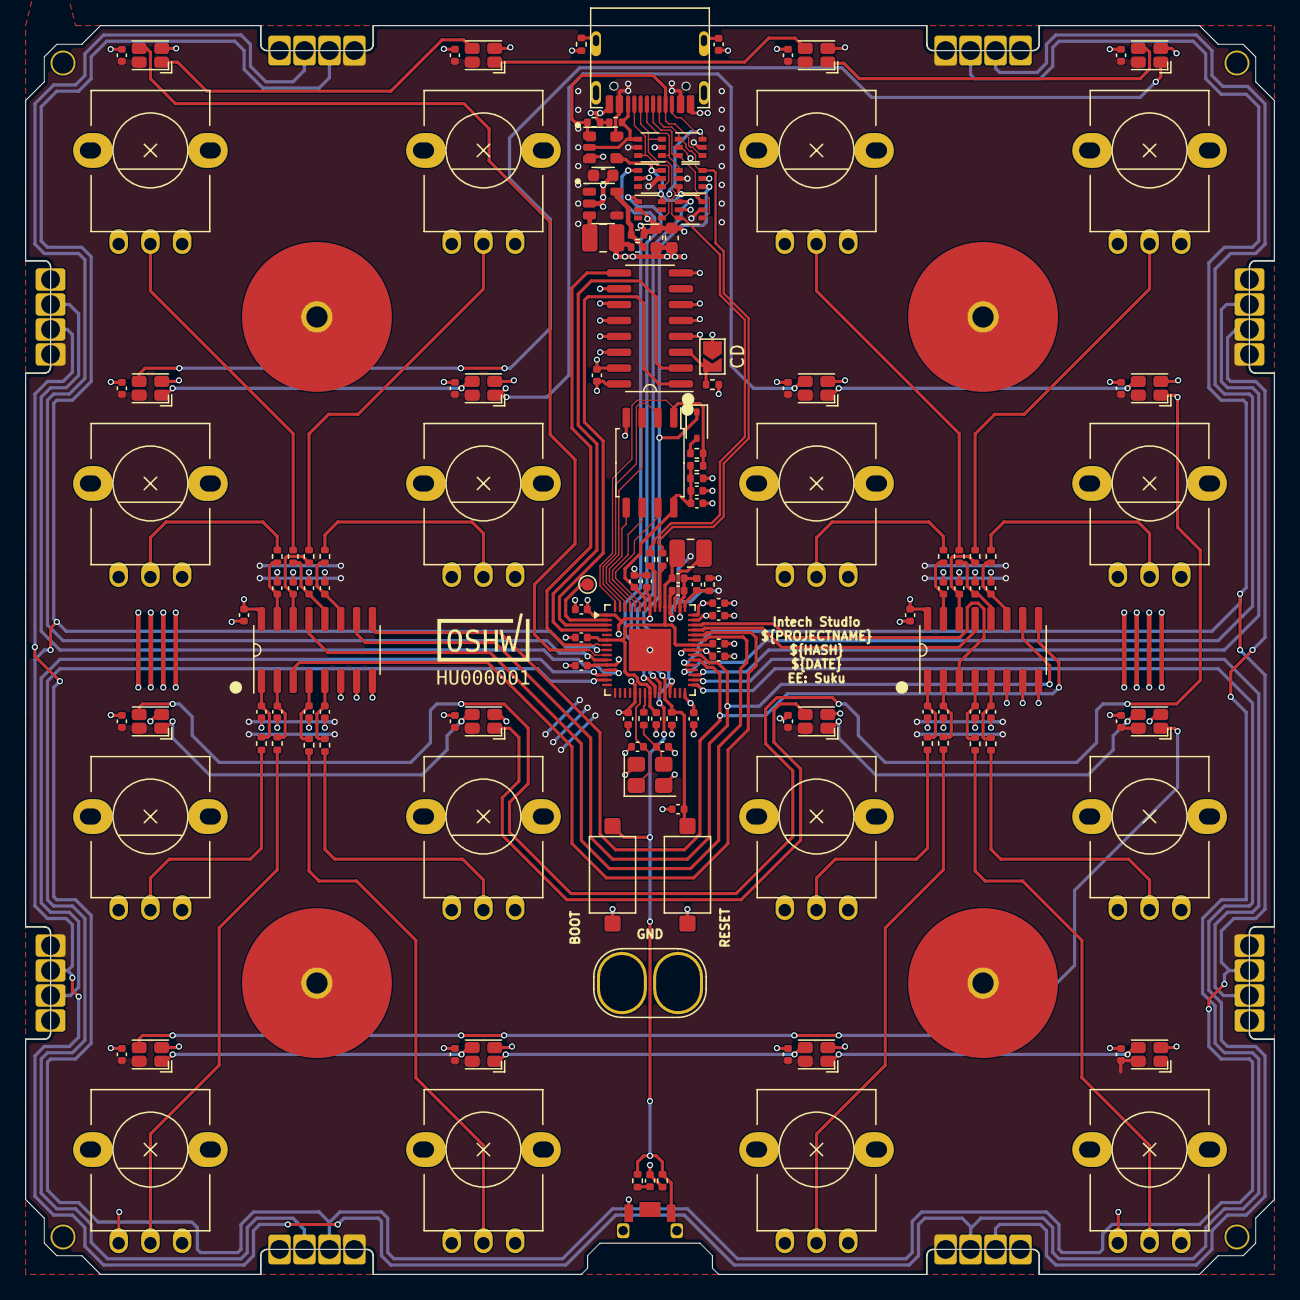
[picture p16: board PCBA-PO16.kicad_pcb from above]

Board: 4 copper layers, 100.0 x 100.0 mm, 158 parts (0 on the bottom side), 106 nets.
