intechstudio/grid-hardware/Electrical/Experiments/# Legacy/XY_TOUCH/XY/XY_TOUCH/XY_TOUCH.kicad_pcb

## KiCad design Electrical/Experiments/# Legacy/XY_TOUCH/XY/XY_TOUCH/XY_TOUCH.kicad_pcb (2026-08-25, an earlier design)

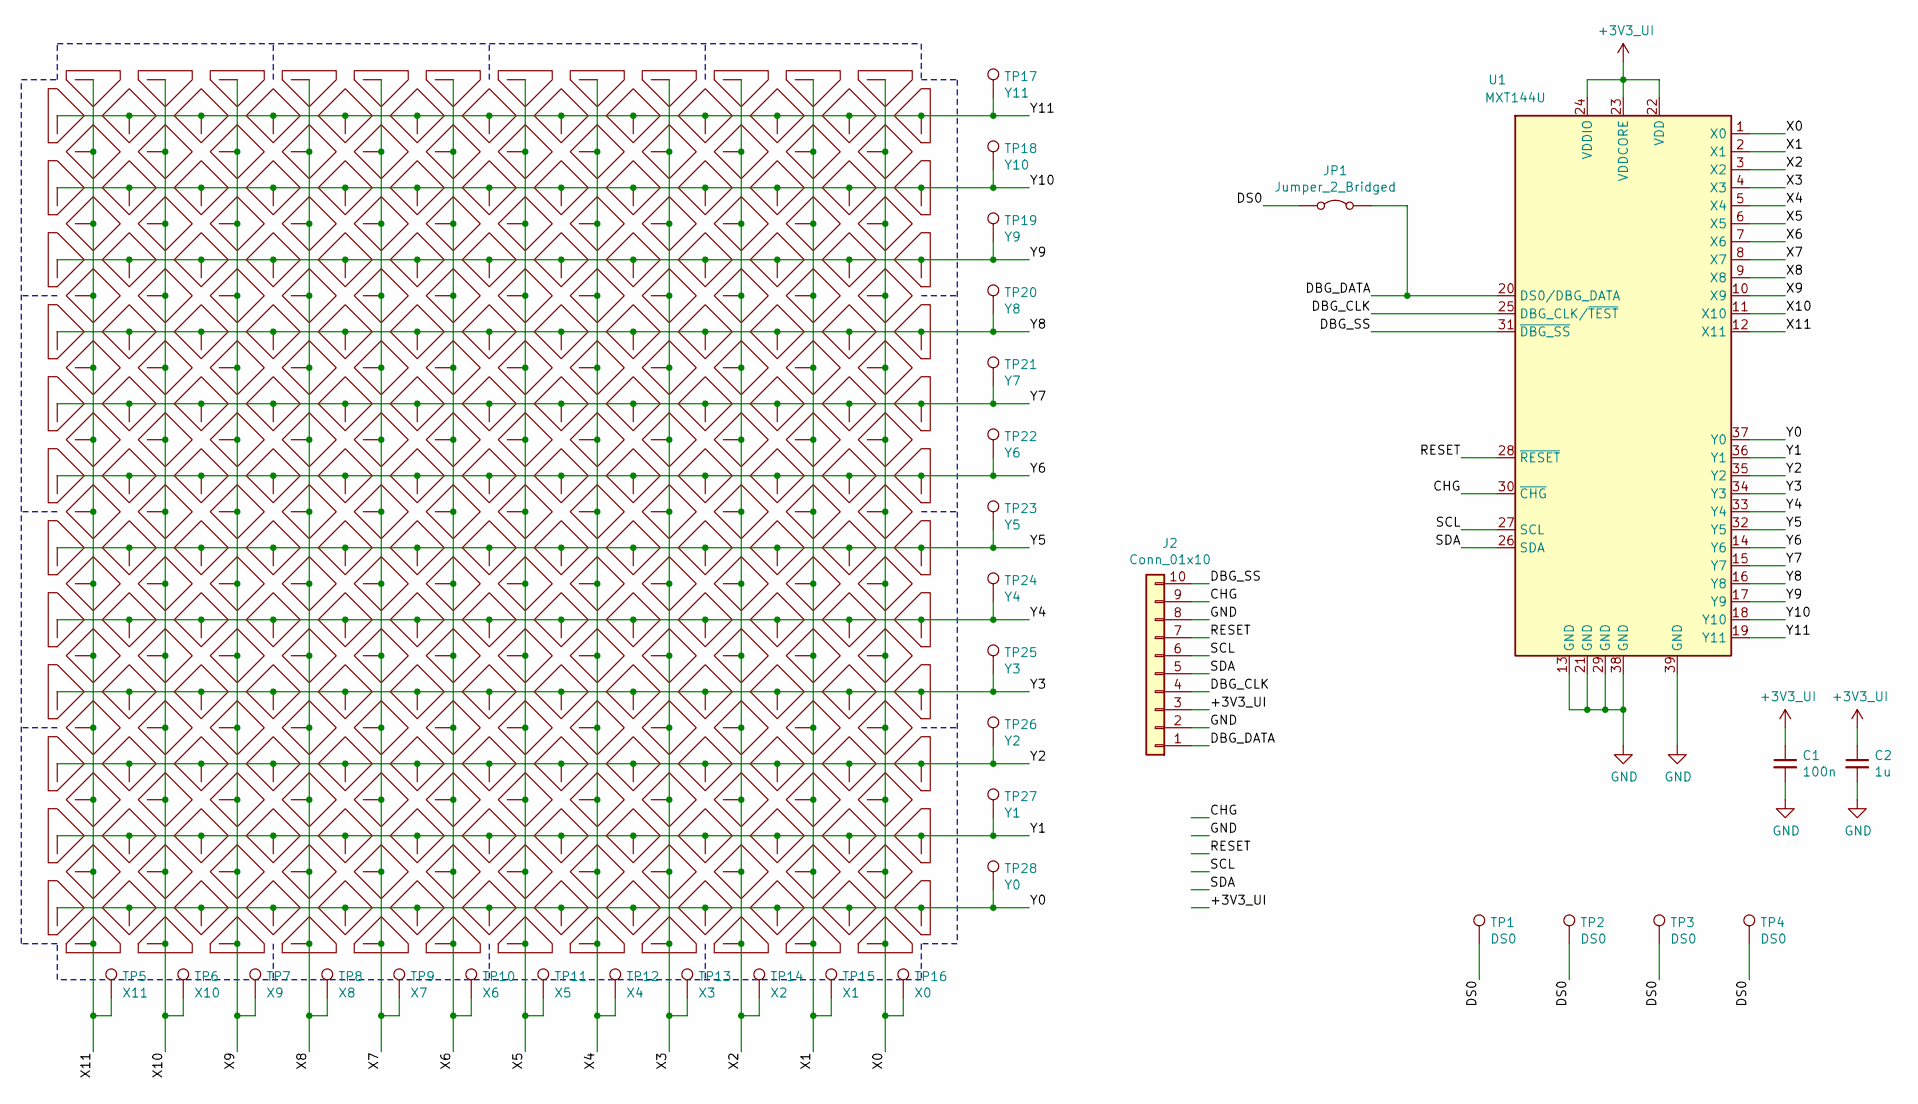
[picture p17: schematic XY_TOUCH.kicad_sch]

Parts:
C1: 100n; CAP_0805
C2: 1u; CAP_0805
CS1, CS4, CS7, CS10, CS25, CS63, CS100, CS138, CS175, CS213, CS250, CS288, CS303, CS306, CS309, CS312: capsense_diamond_edge; capsense_diamond_edge_bite_left
CS2, CS5, CS8, CS11, CS38, CS50, CS113, CS125, CS188, CS200, CS263, CS275, CS302, CS305, CS308, CS311: capsense_diamond_edge
CS3, CS6, CS9, CS12, CS13, CS75, CS88, CS150, CS163, CS225, CS238, CS300, CS301, CS304, CS307, CS310: capsense_diamond_edge; capsense_diamond_edge_bite_right
CS14, CS15, CS17, CS18, CS20, CS21, CS23, CS24, CS26, CS27, CS28, CS29, CS30, CS31, CS32, CS33, CS34, CS35, CS36, CS37, CS39, CS40, CS41, CS42, CS43, CS44, CS45, CS46, CS47, CS48, CS49, CS51, CS52, CS53, CS54, CS55, CS56, CS57, CS58, CS59, CS60, CS61, CS62, CS64, CS65, CS67, CS68, CS70, CS71, CS73, CS74, CS77, CS80, CS83, CS86, CS89, CS90, CS92, CS93, CS95, CS96, CS98, CS99, CS101, CS102, CS103, CS104, CS105, CS106, CS107, CS108, CS109, CS110, CS111, CS112, CS114, CS115, CS116, CS117, CS118, CS119, CS120, CS121, CS122, CS123, CS124, CS126, CS127, CS128, CS129, CS130, CS131, CS132, CS133, CS134, CS135, CS136, CS137, CS139, CS140, CS142, CS143, CS145, CS146, CS148, CS149, CS152, CS155, CS158, CS161, CS164, CS165, CS167, CS168, CS170, CS171, CS173, CS174, CS176, CS177, CS178, CS179, CS180, CS181, CS182, CS183, CS184, CS185, CS186, CS187, CS189, CS190, CS191, CS192, CS193, CS194, CS195, CS196, CS197, CS198, CS199, CS201, CS202, CS203, CS204, CS205, CS206, CS207, CS208, CS209, CS210, CS211, CS212, CS214, CS215, CS217, CS218, CS220, CS221, CS223, CS224, CS227, CS230, CS233, CS236, CS239, CS240, CS242, CS243, CS245, CS246, CS248, CS249, CS251, CS252, CS253, CS254, CS255, CS256, CS257, CS258, CS259, CS260, CS261, CS262, CS264, CS265, CS266, CS267, CS268, CS269, CS270, CS271, CS272, CS273, CS274, CS276, CS277, CS278, CS279, CS280, CS281, CS282, CS283, CS284, CS285, CS286, CS287, CS289, CS290, CS292, CS293, CS295, CS296, CS298, CS299: capsense_diamond
CS16, CS19, CS22, CS66, CS69, CS72, CS76, CS78, CS79, CS81, CS82, CS84, CS85, CS87, CS91, CS94, CS97, CS141, CS144, CS147, CS151, CS153, CS154, CS156, CS157, CS159, CS160, CS162, CS166, CS169, CS172, CS216, CS219, CS222, CS226, CS228, CS229, CS231, CS232, CS234, CS235, CS237, CS241, CS244, CS247, CS291, CS294, CS297: capsense_diamond; capsense_diamond_bite
J2: Conn_01x10; Molex_200528-0100_1x10-1MP_P1.00mm_Horizontal
JP1: Jumper_2_Bridged; SolderJumper-2_P1.3mm_Bridged_RoundedPad1.0x1.5mm
TP1, TP2, TP3, TP4: DS0; TestPoint_THTPad_1.0x1.0mm_Drill0.5mm
TP5: X11; TestPoint_Pad_D1.0mm
TP6: X10; TestPoint_Pad_D1.0mm
TP7: X9; TestPoint_Pad_D1.0mm
TP8: X8; TestPoint_Pad_D1.0mm
TP9: X7; TestPoint_Pad_D1.0mm
TP10: X6; TestPoint_Pad_D1.0mm
TP11: X5; TestPoint_Pad_D1.0mm
TP12: X4; TestPoint_Pad_D1.0mm
TP13: X3; TestPoint_Pad_D1.0mm
TP14: X2; TestPoint_Pad_D1.0mm
TP15: X1; TestPoint_Pad_D1.0mm
TP16: X0; TestPoint_Pad_D1.0mm
TP17: Y11; TestPoint_Pad_D1.0mm
TP18: Y10; TestPoint_Pad_D1.0mm
TP19: Y9; TestPoint_Pad_D1.0mm
TP20: Y8; TestPoint_Pad_D1.0mm
TP21: Y7; TestPoint_Pad_D1.0mm
TP22: Y6; TestPoint_Pad_D1.0mm
TP23: Y5; TestPoint_Pad_D1.0mm
TP24: Y4; TestPoint_Pad_D1.0mm
TP25: Y3; TestPoint_Pad_D1.0mm
TP26: Y2; TestPoint_Pad_D1.0mm
TP27: Y1; TestPoint_Pad_D1.0mm
TP28: Y0; TestPoint_Pad_D1.0mm
U1: MXT144U; QFN-38_EP_4x4_Pitch0.35mm

Connections:
+3V3_UI: C1.1, C2.1, J2.3, U1.22 (VDD), U1.23 (VDDCORE), U1.24 (VDDIO)
/CHG: J2.9, U1.30 (~CHG)
/DBG_CLK: J2.4, U1.25 (DBG_CLK/~TEST)
/DBG_DATA: J2.1, JP1.2 (B), U1.20 (DS0/DBG_DATA)
/DBG_SS: J2.10, U1.31 (~DBG_SS)
/DS0: JP1.1 (A), TP1.1, TP2.1, TP3.1, TP4.1
/RESET: J2.7, U1.28 (~RESET)
/SCL: J2.6, U1.27 (SCL)
/SDA: J2.5, U1.26 (SDA)
/X0: CS288.1, CS289.1, CS290.1, CS291.1, CS292.1, CS293.1, CS294.1, CS295.1, CS296.1, CS297.1, CS298.1, CS299.1, CS300.1, TP16.1, U1.1 (X0)
/X1: CS263.1, CS264.1, CS265.1, CS266.1, CS267.1, CS268.1, CS269.1, CS270.1, CS271.1, CS272.1, CS273.1, CS274.1, CS275.1, TP15.1, U1.2 (X1)
/X2: CS238.1, CS239.1, CS240.1, CS241.1, CS242.1, CS243.1, CS244.1, CS245.1, CS246.1, CS247.1, CS248.1, CS249.1, CS250.1, TP14.1, U1.3 (X2)
/X3: CS213.1, CS214.1, CS215.1, CS216.1, CS217.1, CS218.1, CS219.1, CS220.1, CS221.1, CS222.1, CS223.1, CS224.1, CS225.1, TP13.1, U1.4 (X3)
/X4: CS188.1, CS189.1, CS190.1, CS191.1, CS192.1, CS193.1, CS194.1, CS195.1, CS196.1, CS197.1, CS198.1, CS199.1, CS200.1, TP12.1, U1.5 (X4)
/X5: CS163.1, CS164.1, CS165.1, CS166.1, CS167.1, CS168.1, CS169.1, CS170.1, CS171.1, CS172.1, CS173.1, CS174.1, CS175.1, TP11.1, U1.6 (X5)
/X6: CS138.1, CS139.1, CS140.1, CS141.1, CS142.1, CS143.1, CS144.1, CS145.1, CS146.1, CS147.1, CS148.1, CS149.1, CS150.1, TP10.1, U1.7 (X6)
/X7: CS113.1, CS114.1, CS115.1, CS116.1, CS117.1, CS118.1, CS119.1, CS120.1, CS121.1, CS122.1, CS123.1, CS124.1, CS125.1, TP9.1, U1.8 (X7)
/X8: CS88.1, CS89.1, CS90.1, CS91.1, CS92.1, CS93.1, CS94.1, CS95.1, CS96.1, CS97.1, CS98.1, CS99.1, CS100.1, TP8.1, U1.9 (X8)
/X9: CS63.1, CS64.1, CS65.1, CS66.1, CS67.1, CS68.1, CS69.1, CS70.1, CS71.1, CS72.1, CS73.1, CS74.1, CS75.1, TP7.1, U1.10 (X9)
/X10: CS38.1, CS39.1, CS40.1, CS41.1, CS42.1, CS43.1, CS44.1, CS45.1, CS46.1, CS47.1, CS48.1, CS49.1, CS50.1, TP6.1, U1.11 (X10)
/X11: CS13.1, CS14.1, CS15.1, CS16.1, CS17.1, CS18.1, CS19.1, CS20.1, CS21.1, CS22.1, CS23.1, CS24.1, CS25.1, TP5.1, U1.12 (X11)
/Y0: CS12.1, CS37.1, CS62.1, CS87.1, CS112.1, CS137.1, CS162.1, CS187.1, CS212.1, CS237.1, CS262.1, CS287.1, CS312.1, TP28.1, U1.37 (Y0)
/Y1: CS11.1, CS36.1, CS61.1, CS86.1, CS111.1, CS136.1, CS161.1, CS186.1, CS211.1, CS236.1, CS261.1, CS286.1, CS311.1, TP27.1, U1.36 (Y1)
/Y2: CS10.1, CS35.1, CS60.1, CS85.1, CS110.1, CS135.1, CS160.1, CS185.1, CS210.1, CS235.1, CS260.1, CS285.1, CS310.1, TP26.1, U1.35 (Y2)
/Y3: CS9.1, CS34.1, CS59.1, CS84.1, CS109.1, CS134.1, CS159.1, CS184.1, CS209.1, CS234.1, CS259.1, CS284.1, CS309.1, TP25.1, U1.34 (Y3)
/Y4: CS8.1, CS33.1, CS58.1, CS83.1, CS108.1, CS133.1, CS158.1, CS183.1, CS208.1, CS233.1, CS258.1, CS283.1, CS308.1, TP24.1, U1.33 (Y4)
/Y5: CS7.1, CS32.1, CS57.1, CS82.1, CS107.1, CS132.1, CS157.1, CS182.1, CS207.1, CS232.1, CS257.1, CS282.1, CS307.1, TP23.1, U1.32 (Y5)
/Y6: CS6.1, CS31.1, CS56.1, CS81.1, CS106.1, CS131.1, CS156.1, CS181.1, CS206.1, CS231.1, CS256.1, CS281.1, CS306.1, TP22.1, U1.14 (Y6)
/Y7: CS5.1, CS30.1, CS55.1, CS80.1, CS105.1, CS130.1, CS155.1, CS180.1, CS205.1, CS230.1, CS255.1, CS280.1, CS305.1, TP21.1, U1.15 (Y7)
/Y8: CS4.1, CS29.1, CS54.1, CS79.1, CS104.1, CS129.1, CS154.1, CS179.1, CS204.1, CS229.1, CS254.1, CS279.1, CS304.1, TP20.1, U1.16 (Y8)
/Y9: CS3.1, CS28.1, CS53.1, CS78.1, CS103.1, CS128.1, CS153.1, CS178.1, CS203.1, CS228.1, CS253.1, CS278.1, CS303.1, TP19.1, U1.17 (Y9)
/Y10: CS2.1, CS27.1, CS52.1, CS77.1, CS102.1, CS127.1, CS152.1, CS177.1, CS202.1, CS227.1, CS252.1, CS277.1, CS302.1, TP18.1, U1.18 (Y10)
/Y11: CS1.1, CS26.1, CS51.1, CS76.1, CS101.1, CS126.1, CS151.1, CS176.1, CS201.1, CS226.1, CS251.1, CS276.1, CS301.1, TP17.1, U1.19 (Y11)
GND: C1.2, C2.2, J2.2, J2.8, U1.13 (GND), U1.21 (GND), U1.29 (GND), U1.38 (GND), U1.39 (GND)

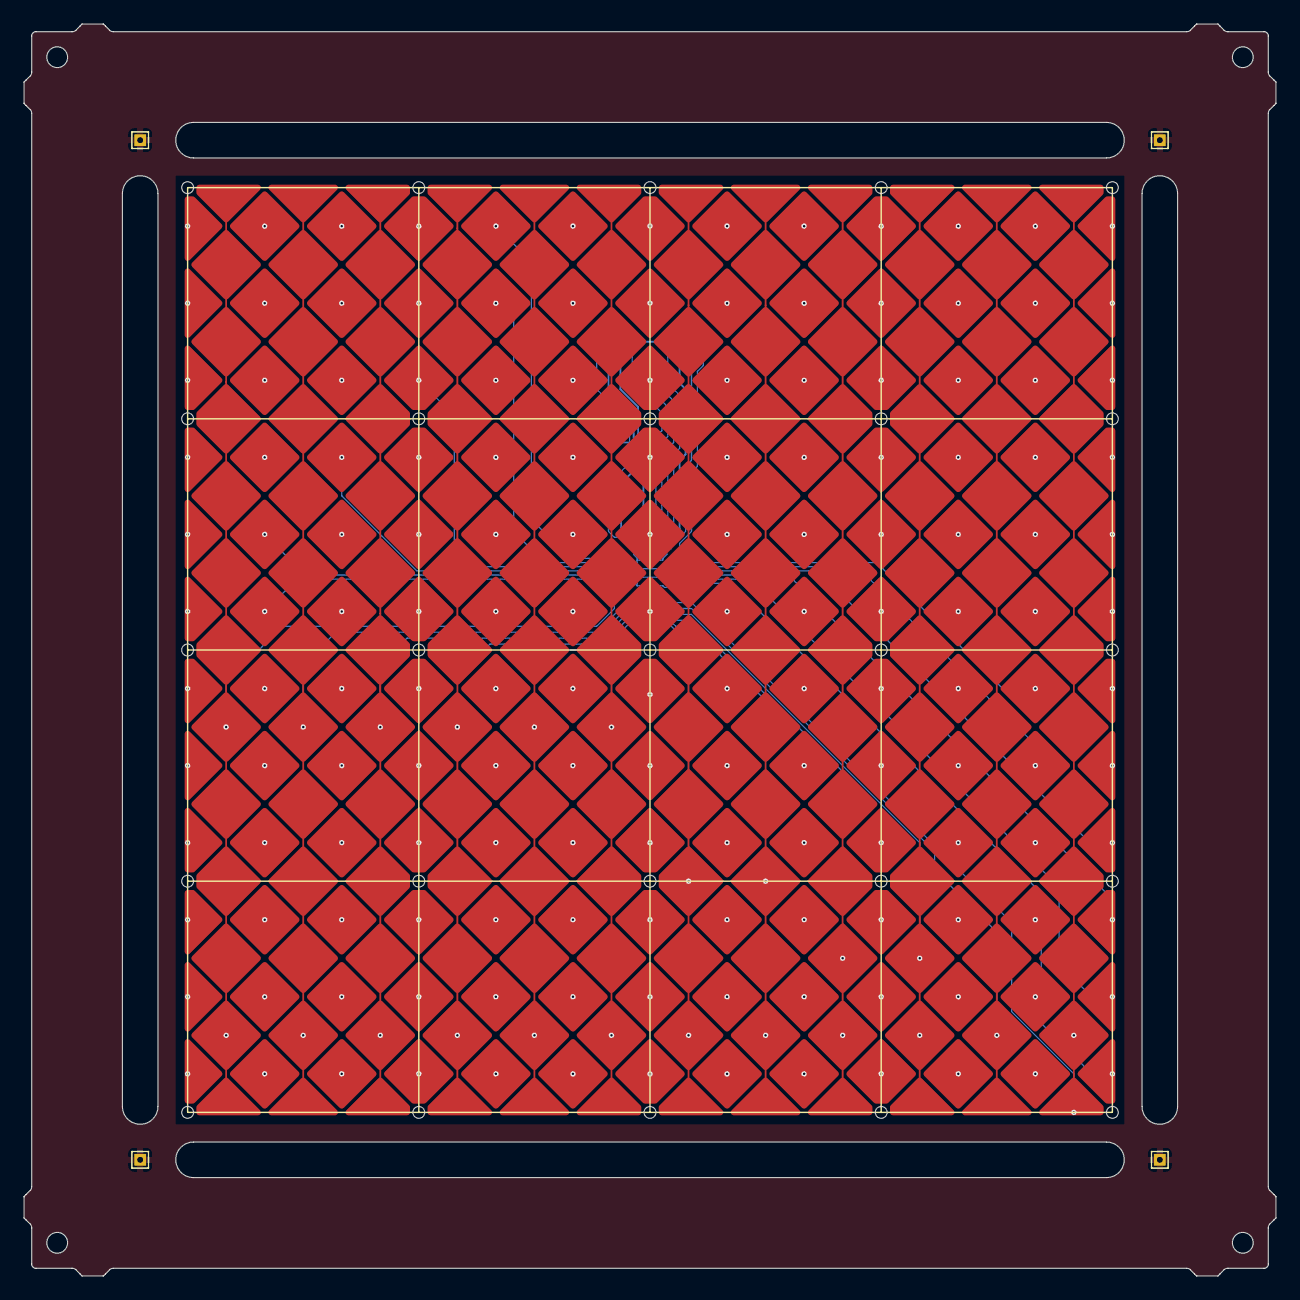
[picture p18: board XY_TOUCH.kicad_pcb from above]

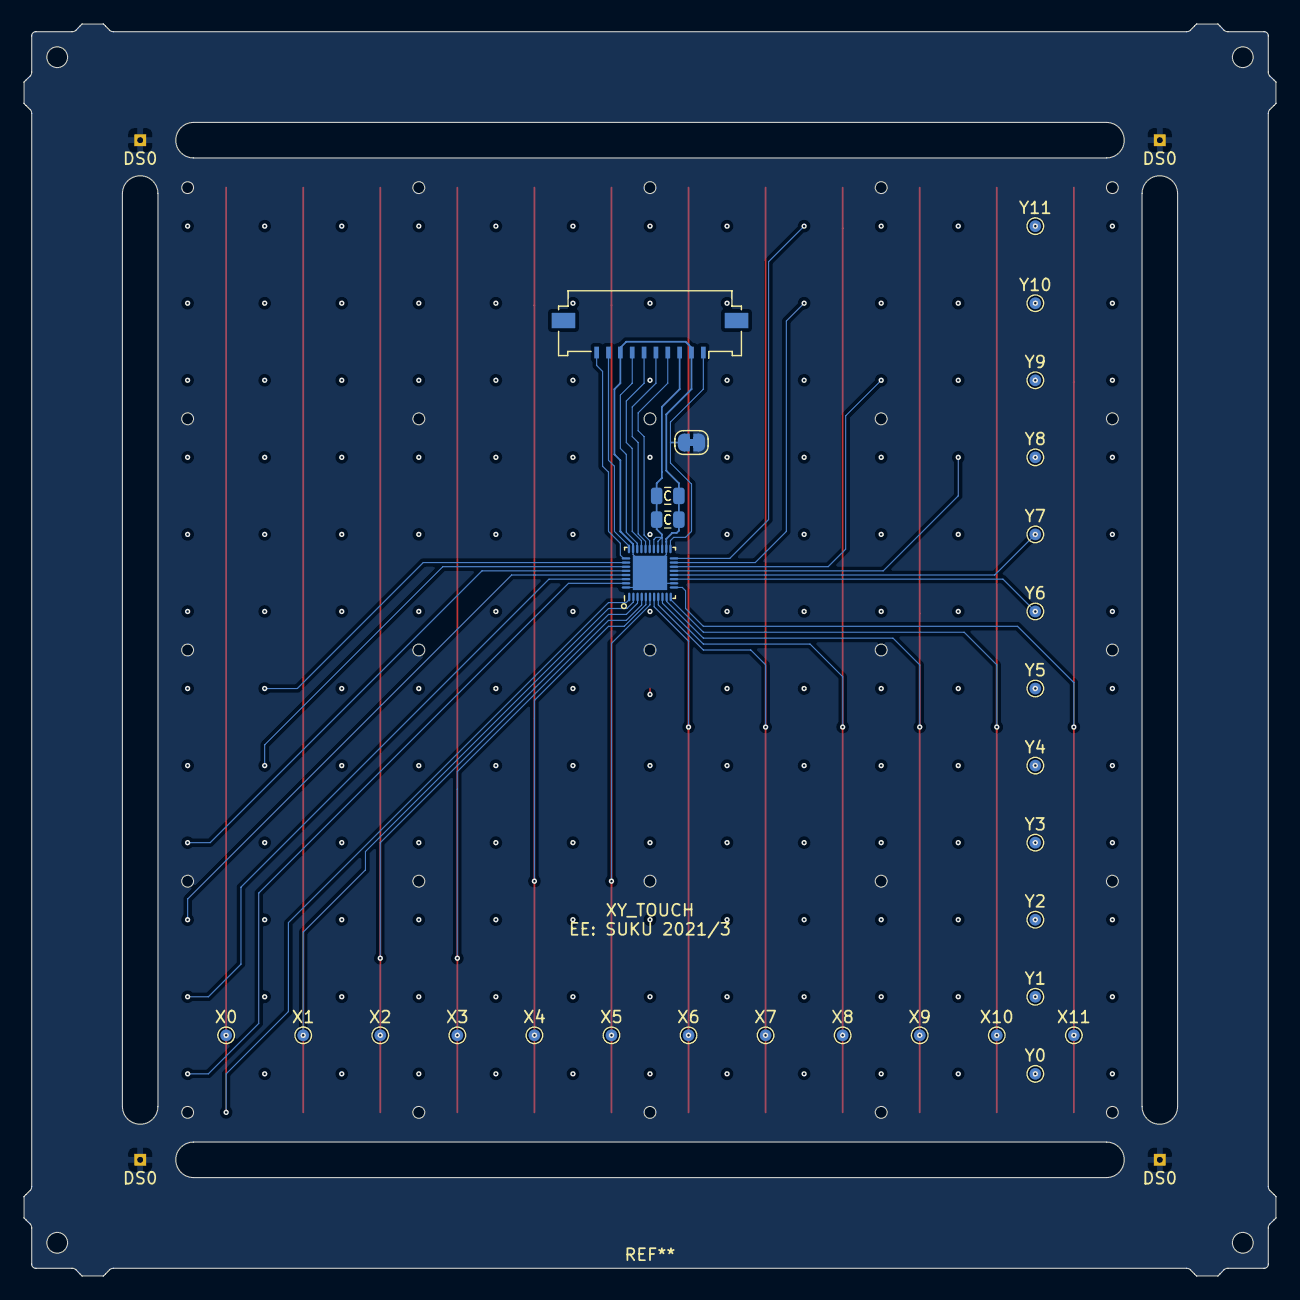
[picture p19: board XY_TOUCH.kicad_pcb from below]

Board: 4 copper layers, 105.6 x 105.6 mm, 345 parts (29 on the bottom side), 34 nets.
