intechstudio/grid-hardware/Electrical/Design/PCBA-DEBUG-UART/PCBA-DEBUG-UART.kicad_pcb

## KiCad design Electrical/Design/PCBA-DEBUG-UART/PCBA-DEBUG-UART.kicad_pcb (2026-08-25)

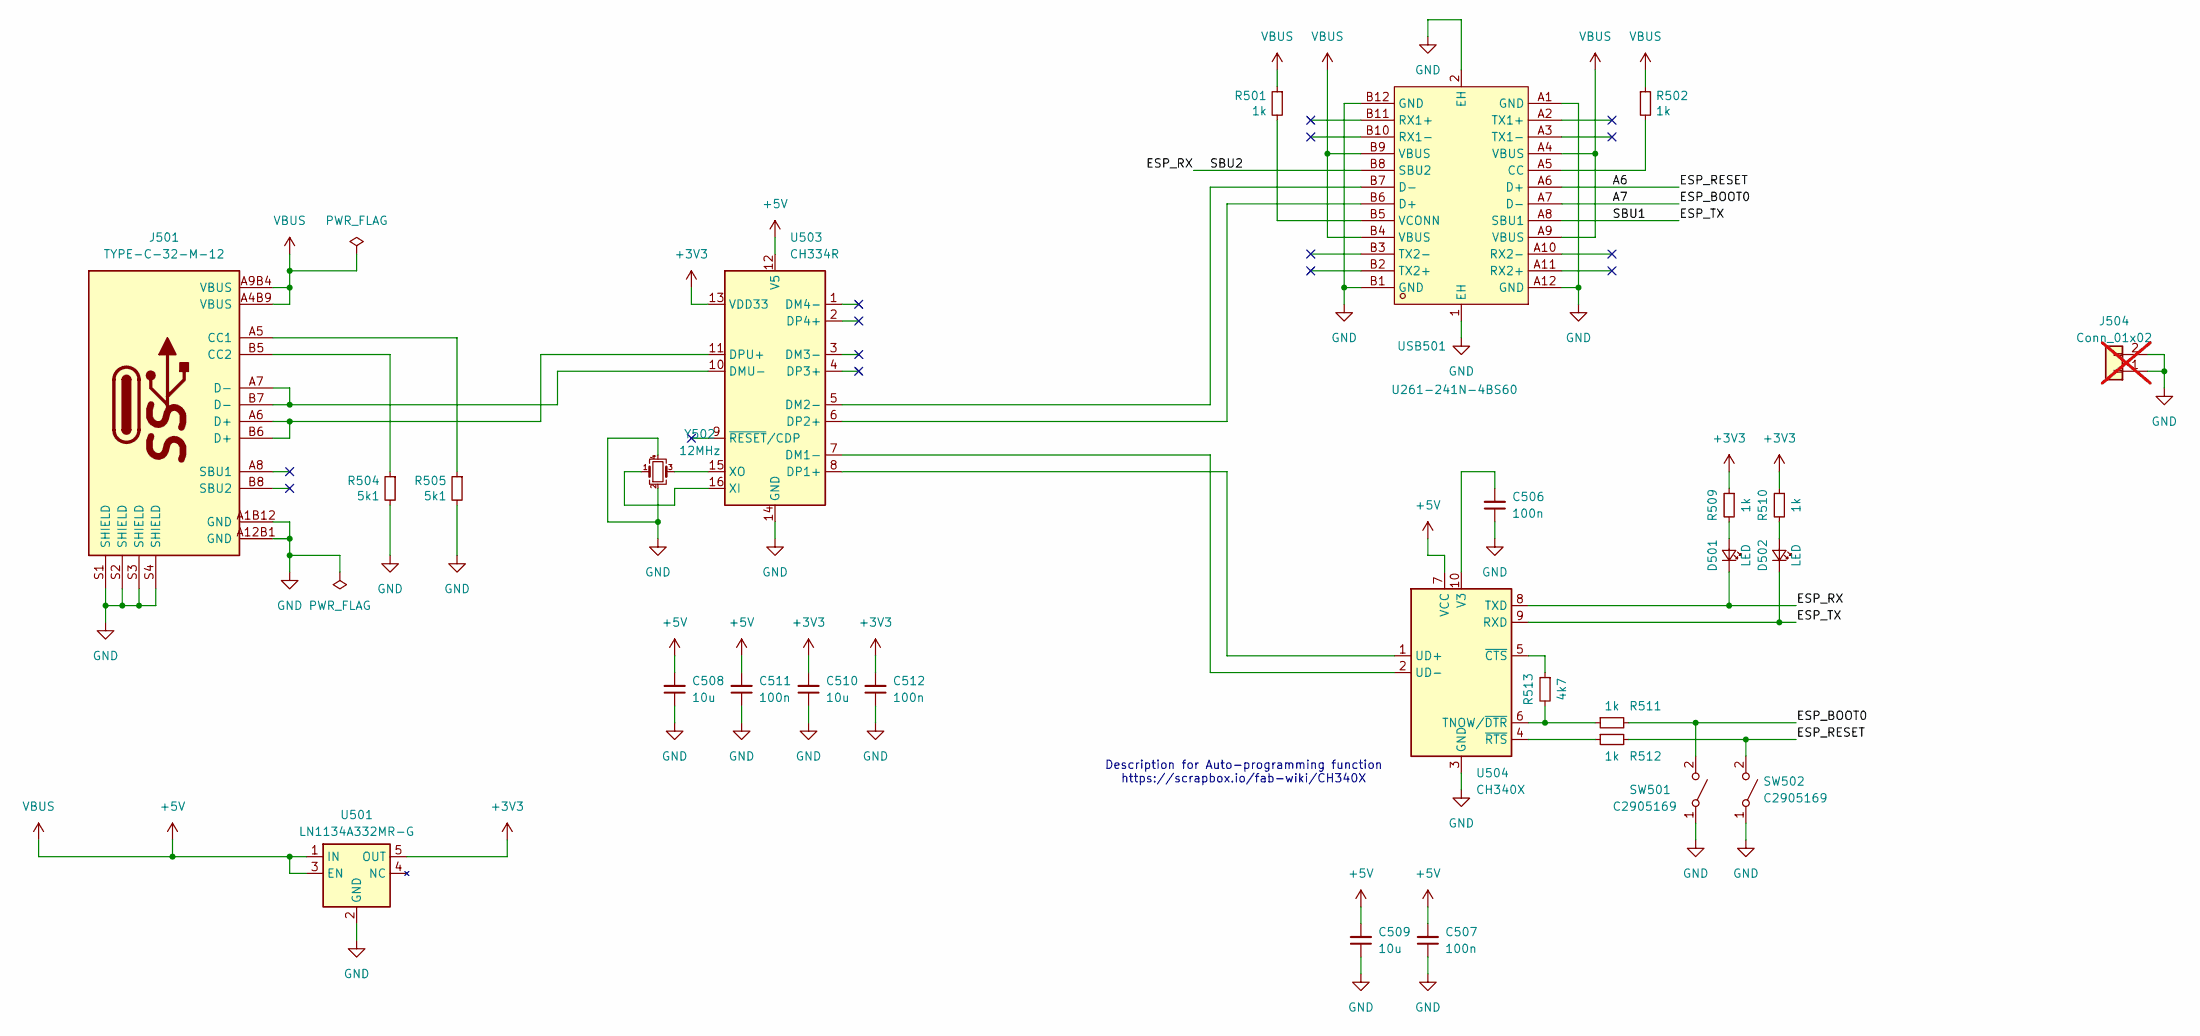
[picture p20: schematic PCBA-DEBUG-UART.kicad_sch]

Parts:
C506, C507, C511, C512: 100n; CAP_0402
C508, C509, C510: 10u; CAP_0402
D501, D502: LED; LED_0402_1005Metric
J501: TYPE-C-32-M-12; USB_C_Korean_Hroparts_TYPE-C-31-M-12
J504: Conn_01x02; OscilloscopeGround; not fitted
R501, R502, R509, R510, R511, R512: 1k; RES_0402
R504, R505: 5k1; RES_0402
R513: 4k7; RES_0402
SW501, SW502: C2905169; SW_SPST_CK_RS282G05A3
U501: LN1134A332MR-G; SOT-23-5
U503: CH334R; QSOP-16_3.9x4.9mm_P0.635mm
U504: CH340X; MSOP-10_3x3mm_P0.5mm
USB501: U261-241N-4BS60; USB-TYPE-C-SMD_U261-241N-4BS60; LCSC Part C319150
Y502: 12MHz; Crystal_SMD_Abracon_ABM8G-4Pin_3.2x2.5mm

Connections:
+3V3: C510.2, C512.2, R509.1, R510.1, U501.5 (OUT), U503.13 (VDD33)
+5V: C507.2, C508.2, C509.2, C511.2, J501.A4B9 (VBUS), J501.A9B4 (VBUS), R501.1, R502.1, U501.1 (IN), U501.3 (EN), U503.12 (V5), U504.7 (VCC), USB501.A4 (VBUS), USB501.A9 (VBUS), USB501.B4 (VBUS), USB501.B9 (VBUS)
/A6: R512.2, SW502.2 (B), USB501.A6 (D+)
/A7: R511.2, SW501.2 (B), USB501.A7 (D-)
/ESP_RX: D501.1 (K), U504.8 (TXD), USB501.B8 (SBU2)
/ESP_TX: D502.1 (K), U504.9 (RXD), USB501.A8 (SBU1)
GND: C506.1, C507.1, C508.1, C509.1, C510.1, C511.1, C512.1, J501.A1B12 (GND), J501.A12B1 (GND), J501.S1 (SHIELD), J501.S2 (SHIELD), J501.S3 (SHIELD), J501.S4 (SHIELD), J504.1, J504.2, R504.2, R505.2, SW501.1 (A), SW502.1 (A), U501.2 (GND), U503.14 (GND), U504.3 (GND), USB501.1 (EH), USB501.2 (EH), USB501.A1 (GND), USB501.A12 (GND), USB501.B1 (GND), USB501.B12 (GND), Y502.2, Y502.4
unnamed: D501.2 (A), R509.2
unnamed: D502.2 (A), R510.2
unnamed: J501.A5 (CC1), R505.1
unnamed: J501.B5 (CC2), R504.1
unnamed: U503.7 (DM1-), U504.2 (UD-)
unnamed: U503.5 (DM2-), USB501.B7 (D-)
unnamed: J501.A7 (D-), J501.B7 (D-), U503.10 (DMU-)
unnamed: U503.8 (DP1+), U504.1 (UD+)
unnamed: U503.6 (DP2+), USB501.B6 (D+)
unnamed: J501.A6 (D+), J501.B6 (D+), U503.11 (DPU+)
unnamed: U503.16 (XI), Y502.1
unnamed: U503.15 (XO), Y502.3
unnamed: R511.1, R513.2, U504.6 (TNOW/~DTR)
unnamed: C506.2, U504.10 (V3)
unnamed: R513.1, U504.5 (~CTS)
unnamed: R512.1, U504.4 (~RTS)
unnamed: R502.2, USB501.A5 (CC)
unnamed: R501.2, USB501.B5 (VCONN)

Notes on the sheet:
Description for Auto-programming function https://scrapbox.io/fab-wiki/CH340X

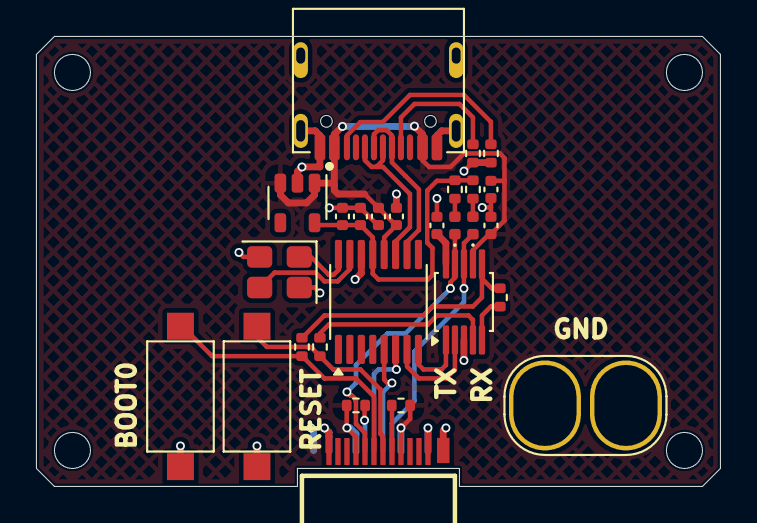
[picture p21: board PCBA-DEBUG-UART.kicad_pcb from above]

Board: 4 copper layers, 38.0 x 25.0 mm, 28 parts (1 on the bottom side), 25 nets.

Other parts of the board:
H534: Outline; OSHWA
