intechstudio/grid-hardware/Electrical/Design/PCBA-INTERFACE/PCBA-INTERFACE.kicad_pcb

## KiCad design Electrical/Design/PCBA-INTERFACE/PCBA-INTERFACE.kicad_pcb (2026-08-25)

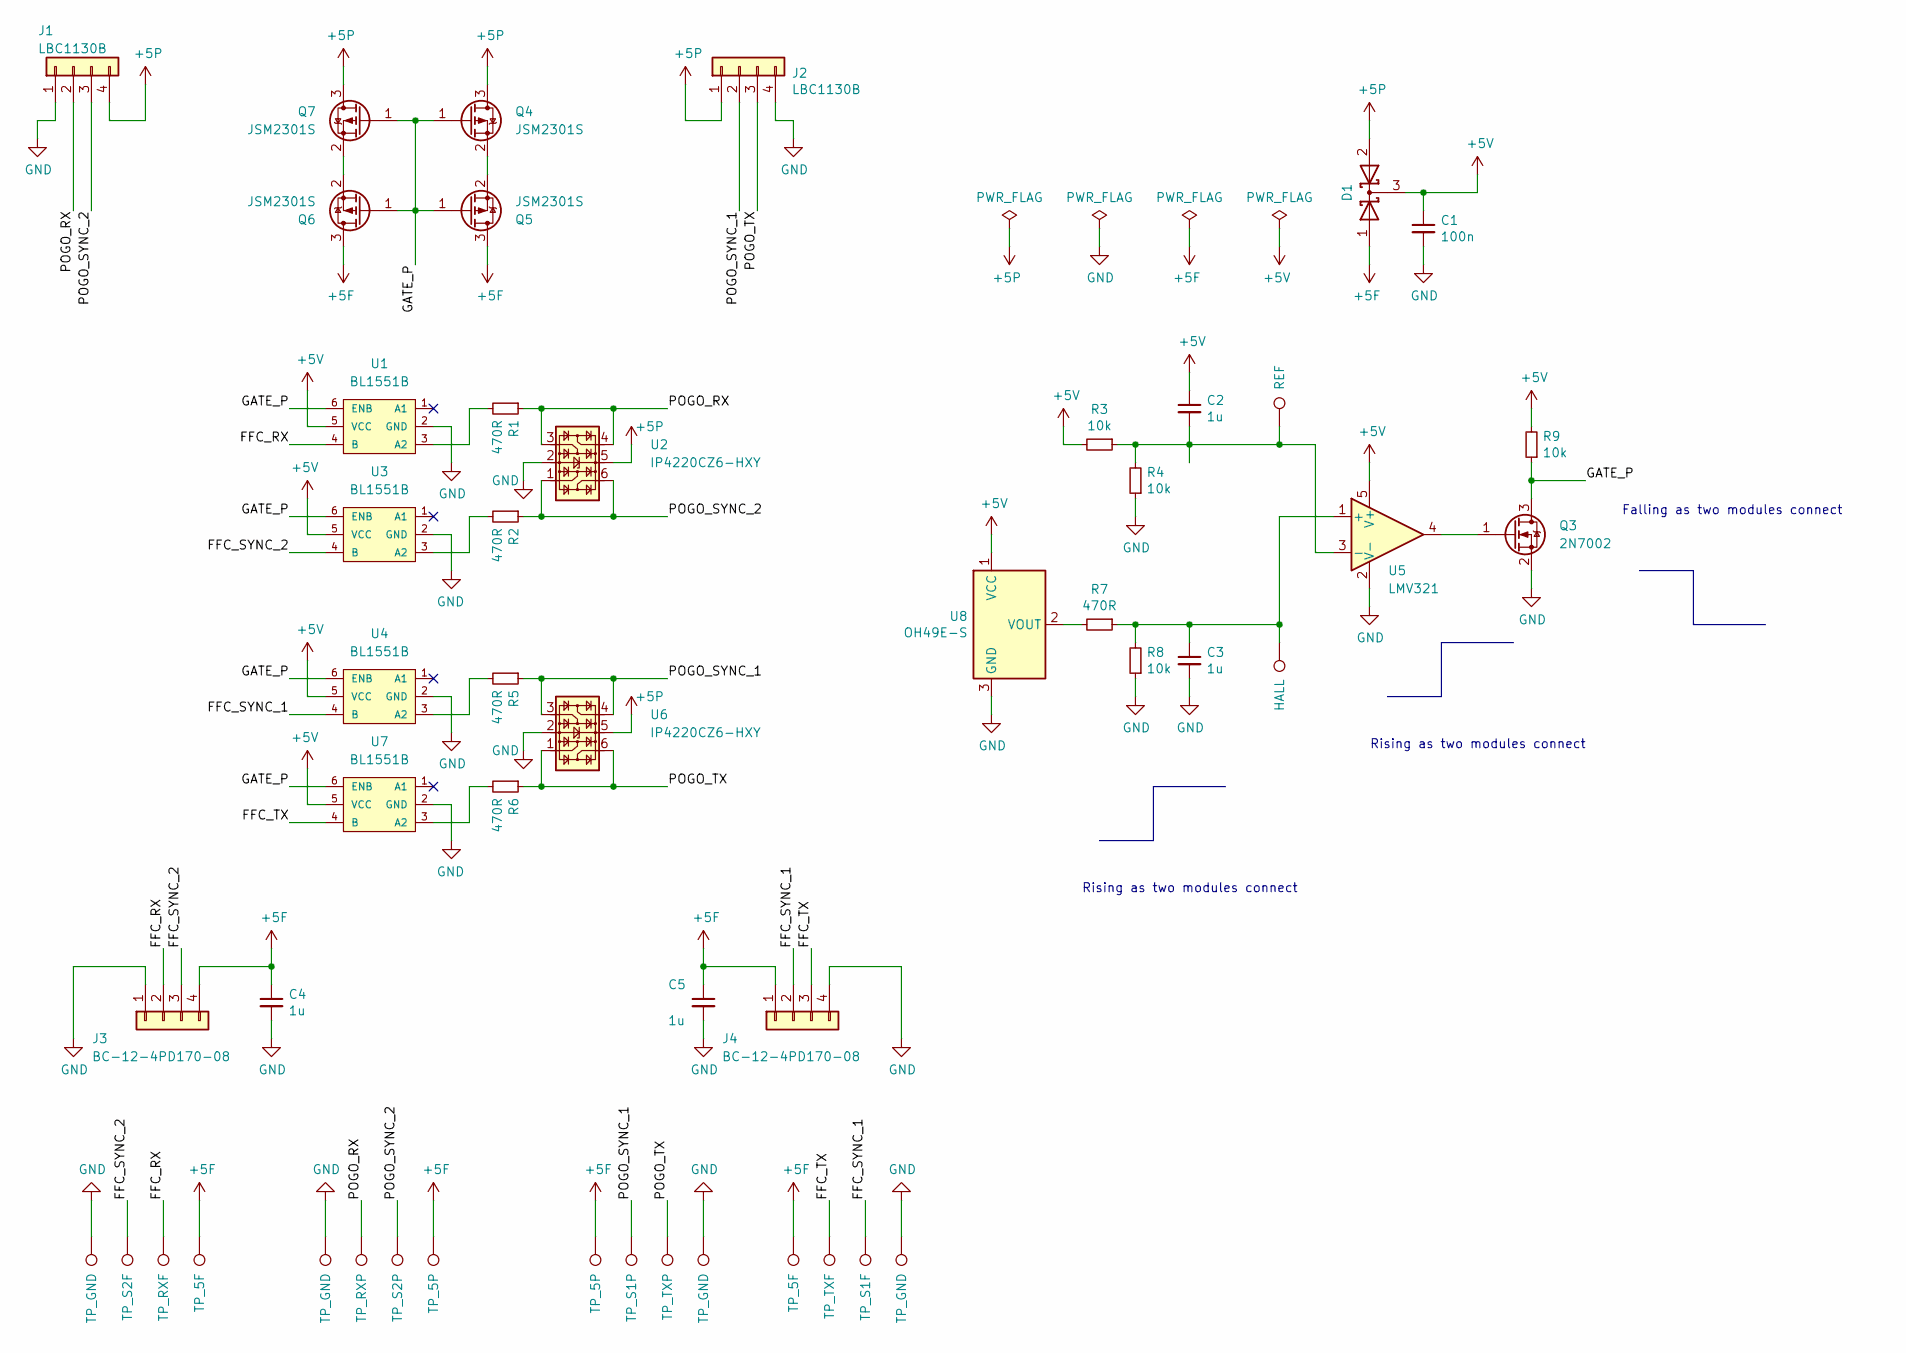
[picture p22: schematic PCBA-INTERFACE.kicad_sch]

Parts:
C1: 100n; CAP_0402
C2, C3, C4, C5: 1u; CAP_0402
D1: BAT54C; SOT-23; Part C375703
J1, J2: LBC1130B; J_4xPOGO_SMD; Part LBC1130B
J3, J4: BC-12-4PD170-08; J_BATTERY_CONN
Q3: 2N7002; SOT-23
Q4, Q5, Q6, Q7: JSM2301S; SOT-23
R1, R2, R5, R6, R7: 470R; RES_0402
R3, R4, R8, R9: 10k; RES_0402
TP1: REF; TestPoint_THTPad_1.0x1.0mm_Drill0.5mm
TP2: HALL; TestPoint_THTPad_1.0x1.0mm_Drill0.5mm
TP3, TP7, TP14, TP18: TP_GND; TestPoint_THTPad_1.0x1.0mm_Drill0.5mm
TP4: TP_S2F; TestPoint_THTPad_1.0x1.0mm_Drill0.5mm
TP5: TP_RXF; TestPoint_THTPad_1.0x1.0mm_Drill0.5mm
TP6, TP15: TP_5F; TestPoint_THTPad_1.0x1.0mm_Drill0.5mm
TP8: TP_RXP; TestPoint_THTPad_1.0x1.0mm_Drill0.5mm
TP9: TP_S2P; TestPoint_THTPad_1.0x1.0mm_Drill0.5mm
TP10, TP11: TP_5P; TestPoint_THTPad_1.0x1.0mm_Drill0.5mm
TP12: TP_S1P; TestPoint_THTPad_1.0x1.0mm_Drill0.5mm
TP13: TP_TXP; TestPoint_THTPad_1.0x1.0mm_Drill0.5mm
TP16: TP_TXF; TestPoint_THTPad_1.0x1.0mm_Drill0.5mm
TP17: TP_S1F; TestPoint_THTPad_1.0x1.0mm_Drill0.5mm
U1, U3, U4, U7: BL1551B; SOT-363_SC-70-6
U2, U6: IP4220CZ6-HXY; SOT-23-6-AND-SOT-363; Part C294963
U5: LMV321; SOT-23-5; Part C90297
U8: OH49E-S; SOT-23W; Part C85573

Connections:
+5F: C4.1, C5.1, D1.1 (A), J3.4, J4.1, Q5.3 (D), Q6.3 (D), TP6.1, TP10.1, TP11.1, TP15.1
+5P: D1.2 (A), J1.4, J2.1, Q4.3 (D), Q7.3 (D), U2.5, U6.5
+5V: C1.1, C2.1, D1.3 (K), R3.2, R9.2, U1.5 (VCC), U3.5 (VCC), U4.5 (VCC), U5.5 (V+), U7.5 (VCC), U8.1 (VCC)
/FFC_RX: J3.2, TP5.1, U1.4 (B)
/FFC_SYNC_1: J4.2, TP17.1, U4.4 (B)
/FFC_SYNC_2: J3.3, TP4.1, U3.4 (B)
/FFC_TX: J4.3, TP16.1, U7.4 (B)
/GATE_P: Q3.3 (D), Q4.1 (G), Q5.1 (G), Q6.1 (G), Q7.1 (G), R9.1, U1.6 (ENB), U3.6 (ENB), U4.6 (ENB), U7.6 (ENB)
/POGO_RX: J1.2, R1.1, TP8.1, U2.3, U2.4
/POGO_SYNC_1: J2.2, R5.1, TP12.1, U6.3, U6.4
/POGO_SYNC_2: J1.3, R2.1, TP9.1, U2.1, U2.6
/POGO_TX: J2.3, R6.1, TP13.1, U6.1, U6.6
GND: C1.2, C3.2, C4.2, C5.2, J1.1, J2.4, J3.1, J4.4, Q3.2 (S), R4.1, R8.1, TP3.1, TP7.1, TP14.1, TP18.1, U1.2 (GND), U2.2, U3.2 (GND), U4.2 (GND), U5.2 (V-), U6.2, U7.2 (GND), U8.3 (GND)
unnamed: Q3.1 (G), U5.4
unnamed: Q4.2 (S), Q5.2 (S)
unnamed: Q6.2 (S), Q7.2 (S)
unnamed: R1.2, U1.3 (A2)
unnamed: R2.2, U3.3 (A2)
unnamed: R5.2, U4.3 (A2)
unnamed: C3.1, R7.1, R8.2, TP2.1, U5.1 (+)
unnamed: C2.2, R3.1, R4.2, TP1.1, U5.3 (-)
unnamed: R6.2, U7.3 (A2)
unnamed: R7.2, U8.2 (VOUT)

Notes on the sheet:
Rising as two modules connect
Falling as two modules connect

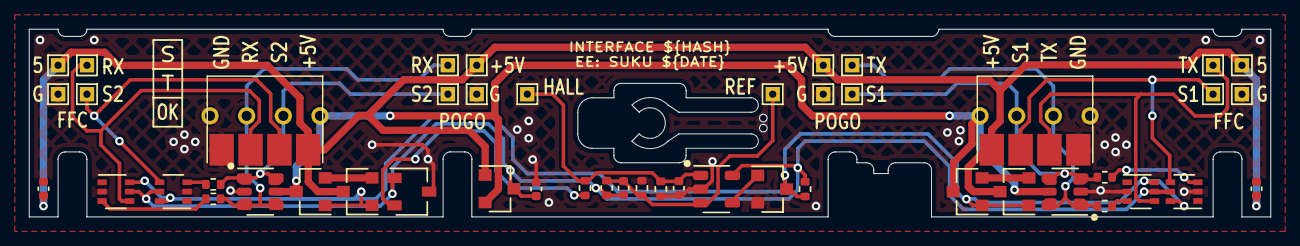
[picture p23: board PCBA-INTERFACE.kicad_pcb from above]

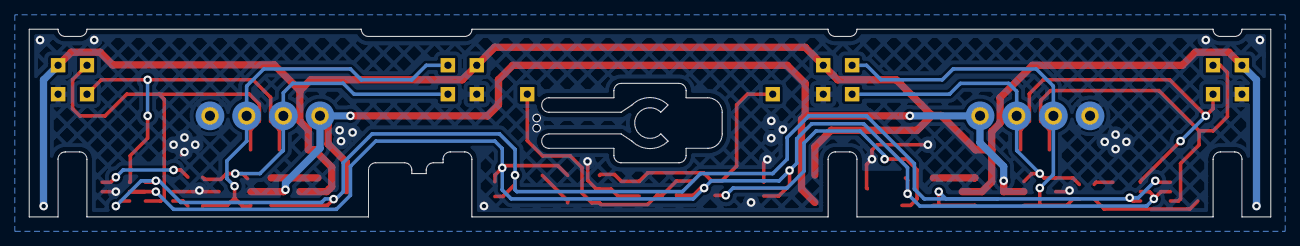
[picture p24: board PCBA-INTERFACE.kicad_pcb from below]

Board: 2 copper layers, 86.0 x 13.0 mm, 50 parts (2 on the bottom side), 23 nets.
