intechstudio/grid-hardware/Electrical/Design/PCBA-DEBUG-ACCESSORY/PCBA-DEBUG-ACCESSORY.kicad_pcb

## KiCad design Electrical/Design/PCBA-DEBUG-ACCESSORY/PCBA-DEBUG-ACCESSORY.kicad_pcb (2026-08-25)

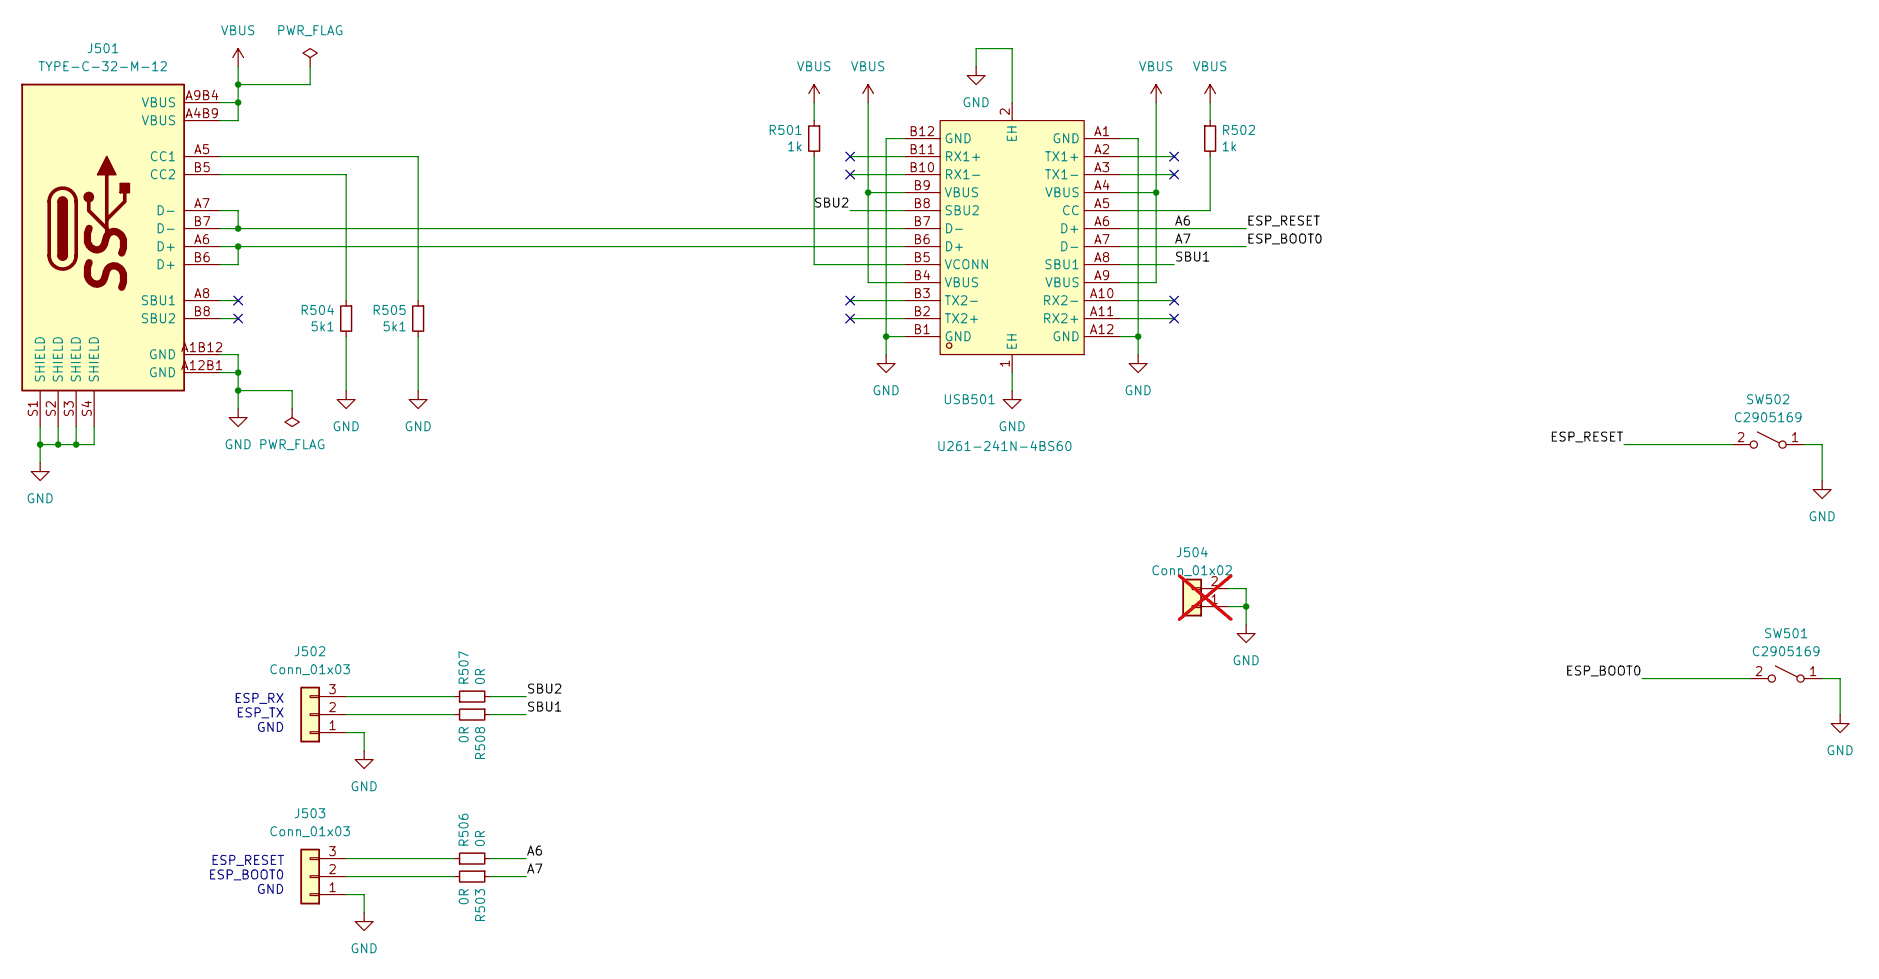
[picture p25: schematic PCBA-DEBUG-ACCESSORY.kicad_sch]

Parts:
J501: TYPE-C-32-M-12; USB_C_Korean_Hroparts_TYPE-C-31-M-12
J502, J503: Conn_01x03; PinHeader_1x03_P2.54mm_Vertical
J504: Conn_01x02; OscilloscopeGround; not fitted
R501, R502: 1k; RES_0402
R503, R506, R507, R508: 0R; RES_0402
R504, R505: 5k1; RES_0402
SW501, SW502: C2905169; SW_SPST_CK_RS282G05A3
USB501: U261-241N-4BS60; USB-TYPE-C-SMD_U261-241N-4BS60; LCSC Part C319150

Connections:
/A6: R506.2, SW502.2 (B), USB501.A6 (D+)
/A7: R503.1, SW501.2 (B), USB501.A7 (D-)
/SBU1: R508.1, USB501.A8 (SBU1)
/SBU2: R507.2, USB501.B8 (SBU2)
GND: J501.A1B12 (GND), J501.A12B1 (GND), J501.S1 (SHIELD), J501.S2 (SHIELD), J501.S3 (SHIELD), J501.S4 (SHIELD), J502.1, J503.1, J504.1, J504.2, R504.2, R505.2, SW501.1 (A), SW502.1 (A), USB501.1 (EH), USB501.2 (EH), USB501.A1 (GND), USB501.A12 (GND), USB501.B1 (GND), USB501.B12 (GND)
unnamed: J501.A5 (CC1), R505.1
unnamed: J501.B5 (CC2), R504.1
unnamed: J501.A6 (D+), J501.B6 (D+), USB501.B6 (D+)
unnamed: J501.A7 (D-), J501.B7 (D-), USB501.B7 (D-)
unnamed: J502.2, R508.2
unnamed: J502.3, R507.1
unnamed: J503.2, R503.2
unnamed: J503.3, R506.1
unnamed: R502.2, USB501.A5 (CC)
unnamed: R501.2, USB501.B5 (VCONN)
VBUS: J501.A4B9 (VBUS), J501.A9B4 (VBUS), R501.1, R502.1, USB501.A4 (VBUS), USB501.A9 (VBUS), USB501.B4 (VBUS), USB501.B9 (VBUS)

Notes on the sheet:
ESP_RESET ESP_BOOT0 GND
ESP_RX ESP_TX GND

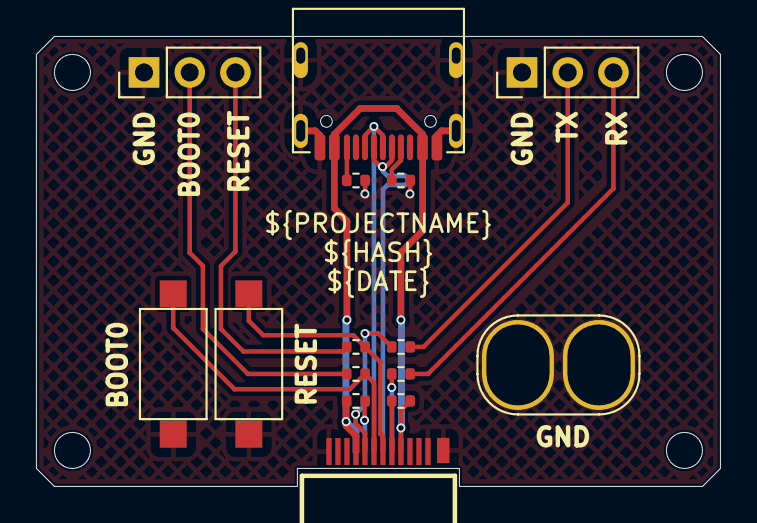
[picture p26: board PCBA-DEBUG-ACCESSORY.kicad_pcb from above]

Board: 2 copper layers, 38.0 x 25.0 mm, 16 parts (1 on the bottom side), 16 nets.

Other parts of the board:
H534: Outline; OSHWA
